OS-MPI/Small-Bore-Imager/Images/1120_Shift Coil Assembly_V1.jpg

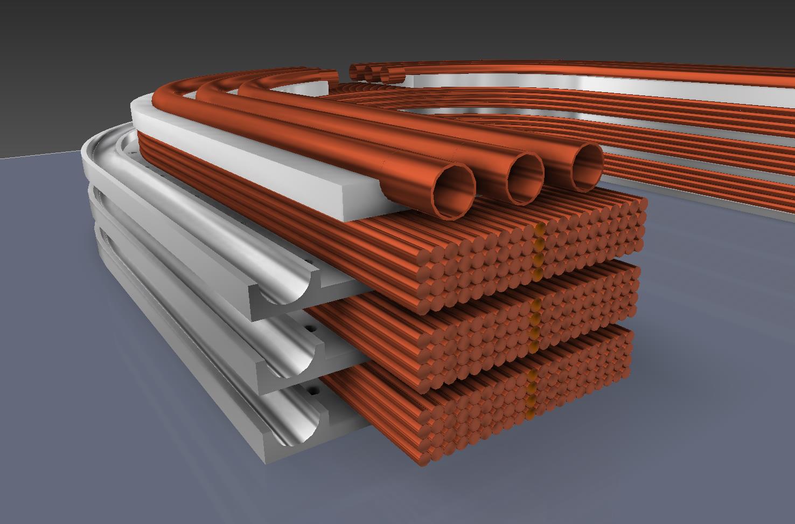
Images/1120_Shift Coil Assembly_V1.jpg
