OS-MPI/Small-Bore-Imager/Images/3100_TxRx Assembly_V1.png

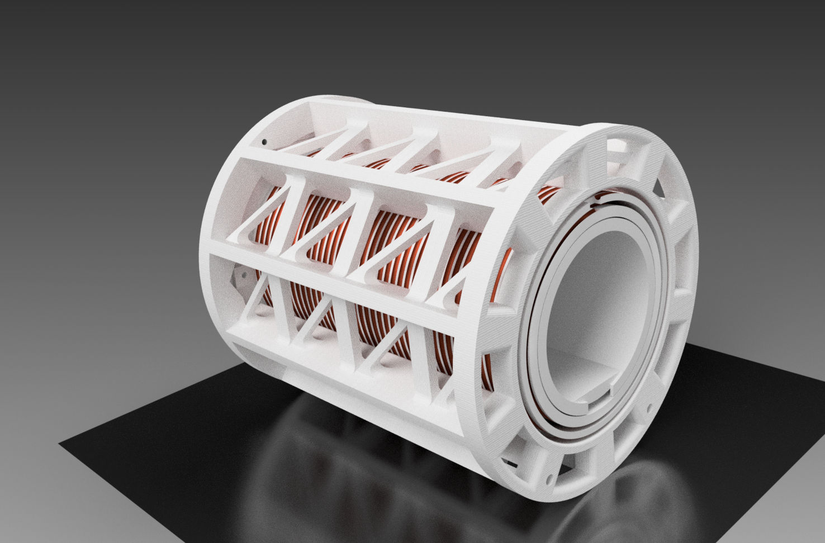
Images/3100_TxRx Assembly_V1.png
