OS-MPI/Small-Bore-Imager/README.md

# Small Bore Imager
# [Link to Wiki](https://github.com/OS-MPI/Small-Bore-Imager/wiki)



This project encompasses the small-bore imager platform with all supporting files and documentation
