OS-MPI/Small-Bore-Imager/General Documentation/Modeling/Magnetics/Symmetry_Sims_Figure.pptx

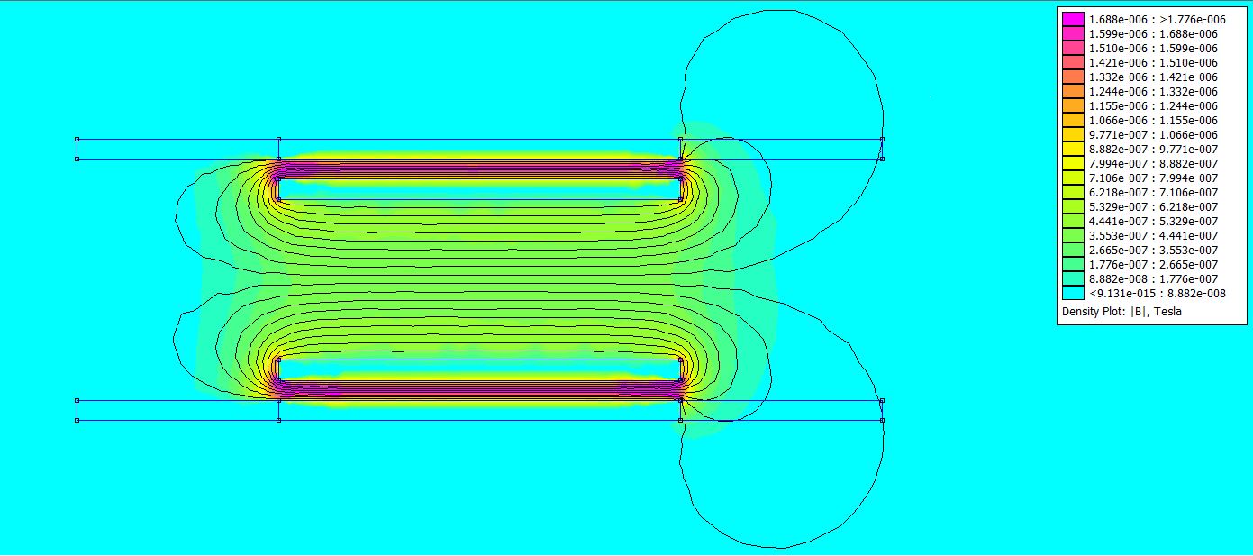
[picture p3: figure]

Copper Tube

Solenoid

Solenoid

Copper Tube
