OS-MPI/Small-Bore-Imager/Filters/Rodent_Tx_filter_Trimmed.pdf

## Small-bore imager drive filter

Eli Mattingly

July 2021

## 1 Introduction

A persistent challenge in the design and construction of the small-bore imaging platform is effectively filtering and optimally powering the drive coil, and then filtering the received signal. This document will summarize the design of these system, in detail. The goal of the filter is to allow for the coil to be powered with a maximally pure waveform as well as being optimally thermally stable.

## 2 Drive Filter

### 2.1 Optimal impedance matching

The drive coil is an inductor with an impedance (ignoring parasitics) of ZL = jωLD + RD, where LD and RD and are the drive coil’s inductance (130µH) and series resistance(400mΩ) respectively, as seen in fig. 2. The amplifier (AE Techron 7548) is a voltage source that for maximum power delivery will drive a 4Ω load. This will be modeled as a source impedance of 4Ω (fig. 1) going forward. If we were to directly power the drive coil at 25kHz with the amplifier, the reactive impedance of the drive coil would dominate:

2 ∗ jωVS

4Ω

Figure 1: The equivalent model for the amplifier. The source resistance is not physical but rather is included to ensure the load is matched to a proper source impedance. In order to ensure the voltage is seen at the load is jωVs and compensate for the artificial resistor, the source voltage is doubled. See appendix A for more detail.

ZD =

q
(2 ∗ π ∗ 25kHz ∗ 130µH)
2 + (4Ω + 0.4Ω)² = 20.9Ω | (1)

LD

RD

Figure 2: The model for the drive coil. Winding capacitances are assumed to be negligible.

Resulting in only a small amount of current being delivered to the coil:

ID =

2VS
20.9Ω → 95mA / Volt | (2)

Where the 20.9Ω is the source impedance in series with the load. This reactance can be easily nulled with a series capacitor, such that at the drive frequency ωLD =

1
ωCD

, so:

CD =

1
ω² ∗ LD

=

1
(2 ∗ pi ∗ 25000Hz)

2 ∗ 130µH

= 312nF | (3)

With that capacitor in place the effective circuit is now simply a 400mΩ resistor, but the amplifiers internal current limits would prevent it from maximum power delivery. This is illustrated by the 4Ω source resistance, which effectively divides the voltage seen at the load. Now the drive coil would receive:

ID =

2VS
4.4Ω = 450mA / Volt | (4)

Which is much better, but there is still substantial room to improve both in terms of matching and filtering. The issue currently is the load is not impedance matched to the source. Ideally, for maximum power delivery, the load would present itself as 4 Ohms to the source.
To accomplish this, we can simply add an impedance matching stage as seen in figure 3. Defining the “matching factor (m)” as the relative ratios of source and load impedance:

m =

RS
RL

=

4Ω
0.4Ω = 10 | (5)

And:
Q =

√
m − 1 = 3 | (6)

For matching to occur:
XL = Q ∗ RL = 1.2Ω | (7)

Which, for resonance at the drive frequency requires the capacitor’s reactance to equal:

1
ωC1

= XL ∗ (1 + Q

−2
) → C1 =

1
ω² ∗ L1 ∗ (10/9) = 4.77µF | (8)

Implementing this results in approximately 800mA per volt. This is the nearly the theoretical maximum with this source impedance, because if we consider conservation of energy, the power

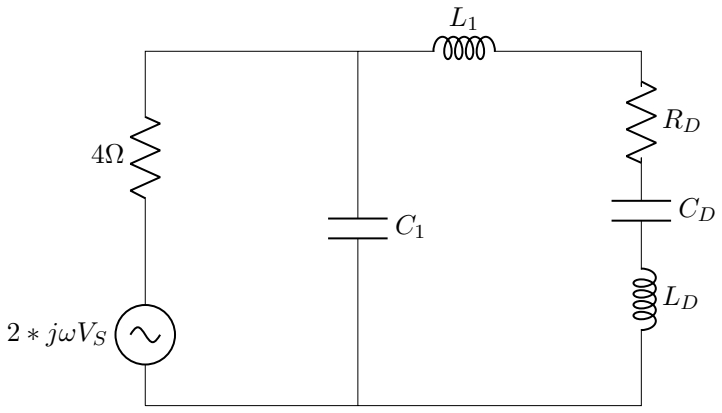
[picture p4: figure]
2 ∗ jωVS

Figure 3: The drive coil circuit with a single impedance matching stage added (L1, C1). In order to form an effective impedance match, L1 = 7.6µH, C1 = 4.7µF, CD = 312nF. This is “Design C-1” in Table 1. L1 can be removed if CD and C1 are picked to be C1 = 4.77µF, CD = 331nF. This version (with no L1) is “Design C-2”.

dissipated by the source PS = V

2/R must equal the power dissipated in the load (if it is perfectly matched and the other elements are ideal). So:

PS = V

2
/R = PD = I

2
D ∗ RD → ID =

s
1
RS ∗ RD
= 800mA / Volt | (9)

In the case where CD is picked properly, we can do the full impedance matching without needing an additional inductor. To do so, we first observe that a parallel capacitor to LD, CD, RD will only add positive imaginary components to the admittance (also called the “susceptance”, “B”) when looking from the source. This means the real part of the admittance (called the “conductance”, G) of the series components, LD, CD, RD must equal 1
RS

. For this to occur, the following must hold:

XSeries = +QRD | (10)

Where the Q is the same as previously defined. The necessary series capacitor is straightforward to calculate:

XSeries = XC + XL | (11)
XC = −(XL − QRD) = 1.2 − 20.4Ω = −19.2Ω = −1 ωCD

(12)

CD =

1
ωXC
= 331nF | (13)

The equivalent impedance of the series drive coil with capacitor is now RD + jQRD. To remove the imaginary component, we first convert the impedance(Z) to an admittance(Y) given Z = 1/Y . Now, looking from the source, the admittance looks like:

Y =

1
RD + jQRD

(14)

Multiplying the numerator and denominator by the complex conjugate gives:

Y =

RD − jQRD
(RD + jQRD)(RD − jQRD)

=

RD − jQRD
(R²
D + (QRD)

2)

=

RD
R²
D(1 + Q²)

−

jQRD
R²
D(1 + Q²)

(15)

Utilizing Eqns. 5,6 gives:

Y =

RD
R²
D(Rs/RD)

−

jQRD
R²
D(Rs/RD)

=

1
Rs

−

jQ
Rs

(16)

Therefore, the susceptance of the shunt capacitor must equal:

BC = +

Q
RS
= ωC | (17)

Which results in a capacitor of:

C = +

Q
ωRS
= 4.77µF | (18)

With that implemented, the equivalent input impedance at the drive frequency is equal to:

Z =

1
Y
= RS | (19)

A third alternative design would be to impedance match to the drive coil’s reactive and resistive load without adding a capacitor and cancel the reactance with a parallel C to the drive and a series L before that as in figure 4, and this results in L2 = 410µH, C2 = 410nF. While the inductor value is very large, the current flowing through is roughly 3x less than the drive coil, so 9x less power/heat (probably 2x resistance, though so overall more like 5x less power than the drive coil). This design is less favorable due to needing to wind another inductor, which can become quite large.

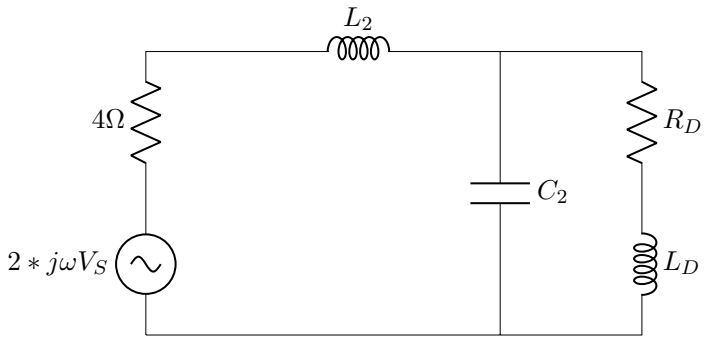
[picture p5: figure]
2 ∗ jωVS

Figure 4: The drive coil circuit with an alternative impedance matching stage added (L2, C2). Note there is no series capacitor to the drive coil.For matching L2 = 409µH, C1 = 410nF. This has the advantage of very low required capacitance. This is “Design D” in Table 1

Regardless of the design specifics, the Q of the filter is dependent on the matching ratio (Eqn. 6). Increasing the filter Q has multiple effects: First, the losses in a filter with higher impedance will be much lower, and second, the way the system drifts with temperature will change–this is discussed later, though. To the first note, we observe for conservation of power (and ignoring filter losses):
I

2
SRS = I

2
DRD | (20)

(

IS
ID

)

2 =

RD
RS

(21)

So, as the source impedance increases, the current decreases. For an impedance matched filter, the same logic holds, where high impedance filters have smaller currents flowing. The characteristic impedance of a filter is defined as:

Z0 =

s
L
C

→ Z

2
0C = L | (22)

and in an ideal resonant circuit energy flows between the inductor and capacitor such that

1/2 ∗ LI² = 1/2 ∗ CV ²
(23)

Plugging in the characteristic impedance and cancelling like terms:

Z

2/0 I

2 = V

2 → Z0 = V /I | (24)

If we consider the losses are proportional to the current squared, then the impedance of the filter is inversely proportional to the losses, squared. This is a simplification of course, as capacitors dissipate heat and resistive components are a function of inductance, but it can still be useful to guide the design.
This suggests a filter matched to a higher impedance would be less lossy at the cost of potentially higher voltages and bigger capacitors and inductors. At higher impedances, the amplifier may lose efficiency, though. Taking AE Techron 7224 as an example, the max power it can transfer at 8 Ohms is 900W, but at 16 Ohms it can still power over 700W. The AE Techron 7548, at 4 Ohms can supply 3300W, but at 16 Ohms it can only supply 1100W. Given the resistance of the drive coil is 400mΩ and we want 25A, that means we only need the amplifier to supply 250W (plus any filter losses).

### 2.2 Filtering

The next challenge is the low F3/F1 attenuation, which can be solved by adding a LC band pass filter with a minimally small pass-band around the drive frequency. So that means making a T network where the series sections are series resonant L-C sections and the shunt sections are parallel L-C sections such that at resonance the series sections have no reactance and minimal resistance, and the shunt sections appear to have practically infinite impedance. With this arrangement, the filter does not alter the impedance matching.

## 3 Transformer Design

Transformers can be used on both the Tx and Rx systems for galvanic isolation, balancing loads, common-mode noise rejection among other reasons. While they present an attractive option for those reasons, the design must be carefully considered to minimize risk of harmonic distortion, and added noise. In particular, the major risks (in this context) are the core becoming saturated and adding harmonic distortion, heating, or (for Rx) adding resistive noise.
For any transformer, the operation is fundamentally the same: current in the Np primary windings induce an alternating flux, ΦC in the core that energizes the secondary Ns windings with
Ns
Np

volts and an inverse ratio of current (ideally). The ratio of turns therefore is the governing factor for the voltages/currents, but the absolute number of turns in each, in conjunction with geometric/composition parameters, determines the “magnetizing inductance”, LM, the leakage inductance, LL, as well as the flux density in the core, Bc.

First, looking at the inductances, there are two major values to consider. The “magnetizing” inductance, and the second is the “leakage” inductance. Simply, the magnetizing inductance is the integrated flux in the core that couples to the secondary per ampere, and the leakage is the integrated remaining flux per ampere. There is a magnetizing inductance for both the primary and secondary.
Next, we must consider the flux density within the core to determine if it will saturate. This was derived in (among other sources) Magnetic Circuits and Transformers, 1943 (Pg. 167-8), and is repeated here for completion. Consider the situation where a transformer (negligible wire losses) has a voltage v applied to the primary side, which must be equivalent to N

dϕ
dt , where N is the
primary-side turn count. ϕ can be written as:
ϕ = ϕmaxsin(ωt) | (25)

differentiating gives:

v = N

dϕ
dt = ωNϕmaxcos(ωt) | (26)

Substituting 2πf for ω and solving for ϕmax, and recognizing the cosine goes to a maximum of 1:

ϕmax =

v
2πfN | (27)

It is worth noting that in many texts it is written as:

vef f =

2πfNϕmax √
2
≈ 4.44fNϕmax | (28)

But this assumes the RMS value. In order to determine saturation or not, it is useful to put it in terms of the flux density, which is a simple transformation as BA = ϕ, so:

Bmax =

v
2πfNA | (29)

This expression is in terms of the voltage at the primary side, but does not include secondary-side effects. This can be explain intuitively, if we assume a near-ideal 1:1 transformer. If a load is applied to the secondary side and draws X amps, the primary side current will increase an equal amount, so the flux within the core remains essentially the same.

### 3.0.1 Equivalent circuit

As mentioned, the transformer has two inductances each, for the primary and secondary side: the “LM”, the magnetizing inductance, and “Ll” the leakage inductance. With these four parameters, an equivalent circuit can be formed as in figure 5. It is common to refer all of the impedances to either the primary or secondary side. For this discussion, the secondary side will be more simple to refer the impedances to.
In the case that the magnetizing inductive impedance is substantially higher than the effective resistive load (at the drive frequency), this term can be ignored. This results in the equivalent circuit simply being a series inductor with a value equal to the sum of the leakages referred to the secondary side. This can be easily tuned out by adding a series capacitor such that it resonates at the drive frequency.

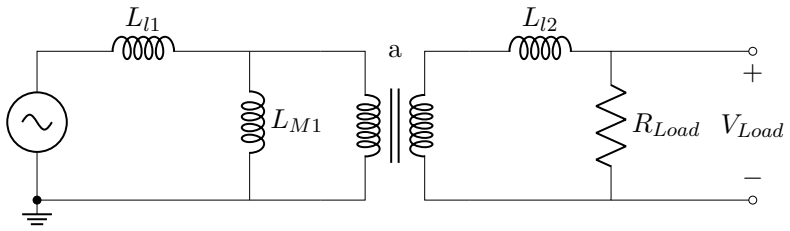
[picture p6: figure]
RLoad; VLoad

Figure 5: Circuit model for a generalized transformer with both secondary and primary-side leakages as well as the magnetizing inductance on the primary side. The transformer in the center is an ideal transformer with a turns ratio equivalent to the square root of the magnetizing inductance ratio (qLM1

LM2

= a). This model assumes negligible capacitive effects, and core losses.

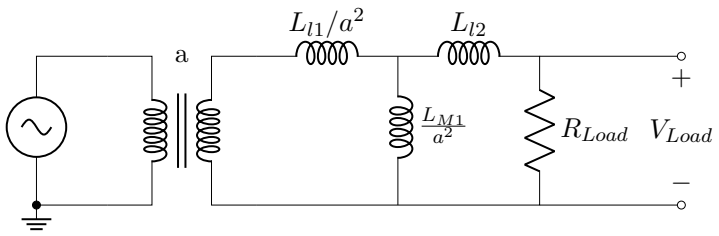
[picture p7: figure]
RLoad; VLoad

Figure 6: Circuit model for a generalized transformer with both secondary and primary-side leakages as well as the magnetizing inductance on the primary side. The transformer in the center is an ideal transformer with a turns ratio equivalent to the square root of the magnetizing inductance ratio (qLM1

LM2

= a).

## 4 Implementation

The discussion has been mostly theory-based so far, which in a general sense is useful to guide a design, but reality tends to fight back on the implementation front. A number of new effects must be considered. Firstly, the amplifier is actually a fairly low impedance source (< 10mΩ) not the four or so Ohms that was assumed earlier. This may result in some unexpected behavior in non-drive frequencies, because now the amplifier can supply substantially more current to low-impedance loads (whereas before the simulated source resistance attenuated it).
The transfer function (voltage input to drive current) ends up having a peak on either side of the drive frequency, which may come as a surprise. The relative location of these peaks depend on which impedance the load is matched to, and a number of different impedances are plotted in figure 7a. When plotting the total efficiency (power out/power in), the drive frequency is indeed the absolute maximum.

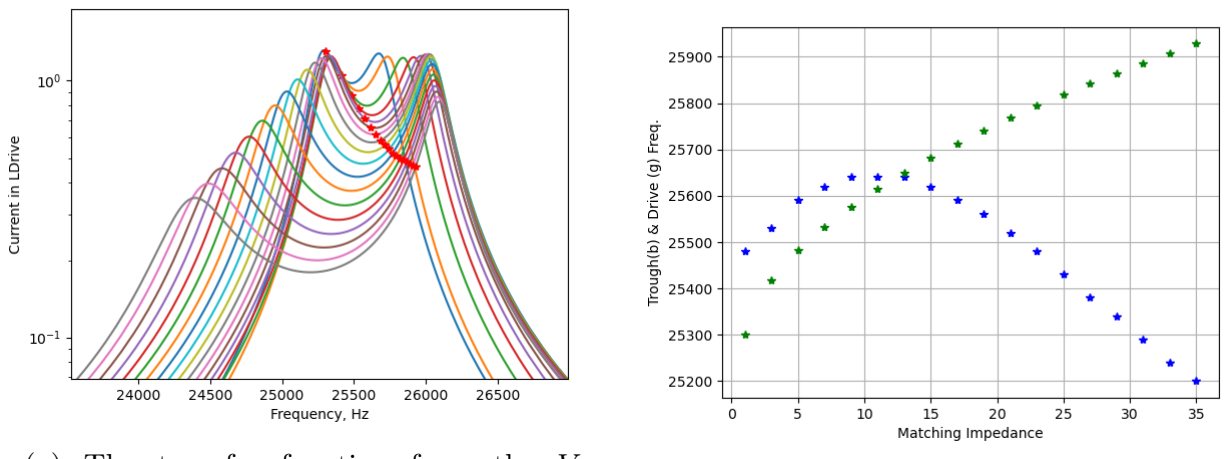
[picture p8: figure]

(a) The transfer function from the Vin to IDrive for many different matching impedances. Red stars are the drive frequencies
(b) The “trough” location and the oper-ating drive frequency at different matched impedances

Figure 7: Impedance matching to different levels (changing matching ratio) causes the relative position of the drive frequency and the “trough”, which is the local minima, to be varied.

## Appendices

## A Modeling voltage sources

Throughout this document I model the amplifier as a voltage source in series with a resistor that is equivalent to the amplifier’s maximum output voltage divided by the maximum current:

RSrc =

VMax

IMax

(30)

This is an approximation that can be used to help design the filter, but this is not a physical effect. As shown in figure 10, it is evident that the match is far from perfect, but it does indeed match exactly at the maximum power point, and roughly matches the off-peak characteristics in that it monotonically attenuates them. If this series resistor, the maximum power would be at zero ohms load as P = V

2/R.

## B Phasor view of impedance matching

A second way to understand the impedance matching is by looking at the phasors of the impedance and admittance depicted in figure 11. From this prespective the steps are more clear: first, looking at the admittance, the goal is to move the green admittance such that the real part is aligned with the target. This is done by adding series capacitance. Next, adding parallel capacitance adds positive, imaginary admittance, so that parallel capacitor is picked to cancel out all of the reactance.

Design | ID per VS | SPICE Source Impedance | F3/F1 | Filer losses
A B C-1 C-2 D E F F-2 | 95mA/V 450mA/V 800mA/V 800mA/V 800mA/V 700mA/V 800mA/V 800mA/V | 20.9Ω, 100◦ ◦ 4.4Ω, 0 8.2Ω, −2 ◦ ◦ 7.9Ω, 2 7.96Ω, 2 ◦ 6.58Ω, 22◦ 8.0Ω, −3 ◦ ◦ 7.94Ω, −3 | -9.4dB -21dB -46dB -46dB -58dB -80dB -81dB -79dB | --30 W -25.4 W 46 W 43.5 W 28 W

Table 1: Tabulated parameters for each of the different filter versions. The SPICE source impedance is in series with the 4 Ω source impedance. For the losses, capacitors are assumed to be ideal, as are wires, and resistance is taken to be approximately 200mΩper√
100µH, so for example, a 25µH would have 100mΩ resistance

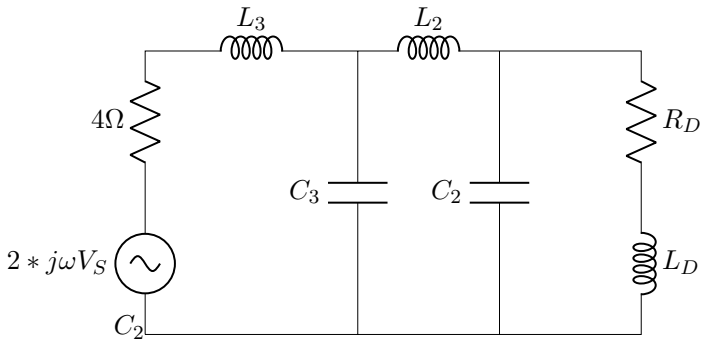
[picture p9: figure]
2 ∗ jωVS

Figure 8: The drive coil circuit with a single impedance matching stage added (L2, C2) as well as a filter (L3, C3) to attenuate harmonic distortions that originate from the amplifier. This is “Design E” in Table 1

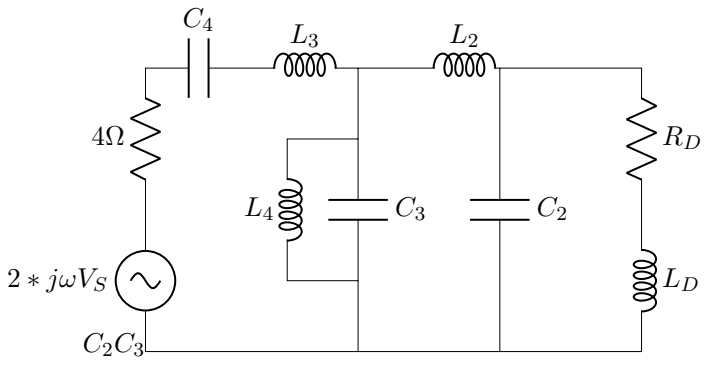
[picture p10: figure]
2 ∗ jωVS

Figure 9: The drive coil circuit with a single impedance matching stage added (L2, C2.) as well as a filter (L3, C3.) which has been tuned such that it is resonant at the drive frequency (L4, C4.). This is “Design F” in Table 1

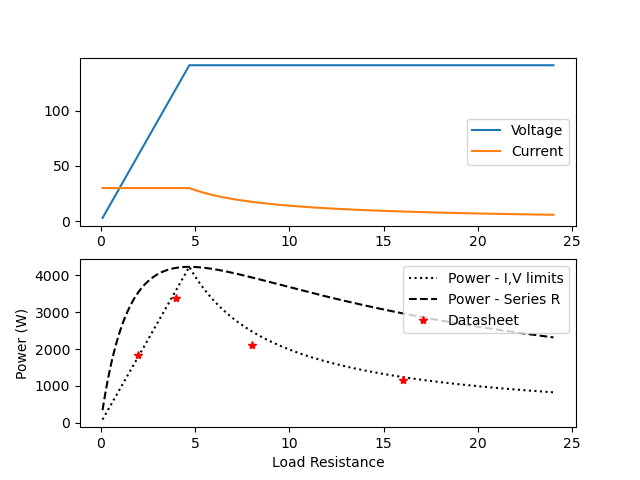
[picture p11: figure]

Figure 10: Top: The actual currents and voltages that one would expect from an amplifier given the maximum current and voltages of the AE Techron 7548 (RMS, steady state). Bottom: The dotted line is the power as a function of load impedance that corresponds to the top I and V. The dashed line is the approximation that utilizes the source having twice the voltage with a series resistance as calculated in Eqn.30. The four red stars are the datapoints found in the AE Techron 7548 datasheet.

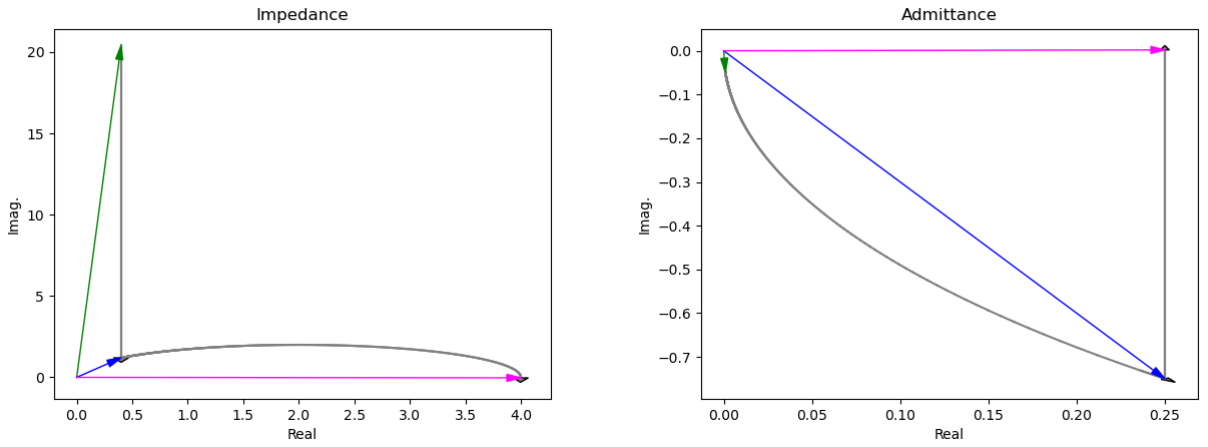
[picture p12: figure]

(a) The impedance phasors | (b) The admittance phasors

Figure 11: Impedance matching from a graphical point of view. The green represents the original impedance , the blue is the drive coil with the 331nF series capacitor, and the magenta is the final, impedance matched system (4.77µF capacitor added in parallel as in design “C-2”.
