OS-MPI/Small-Bore-Imager/Filters/Tx_Filter_SPICE.png

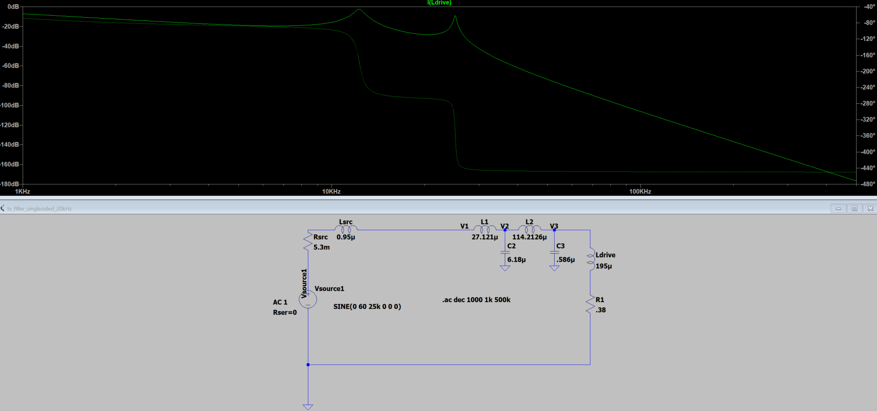
Filters/Tx_Filter_SPICE.png
