OS-MPI/Small-Bore-Imager/Filters/Tx_Filter_SPICE_Detail.png

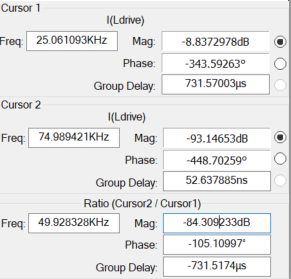
Filters/Tx_Filter_SPICE_Detail.png
