OS-MPI/Small-Bore-Imager/General Documentation/Modeling/Magnetics/FieldSim_40Amps.PNG

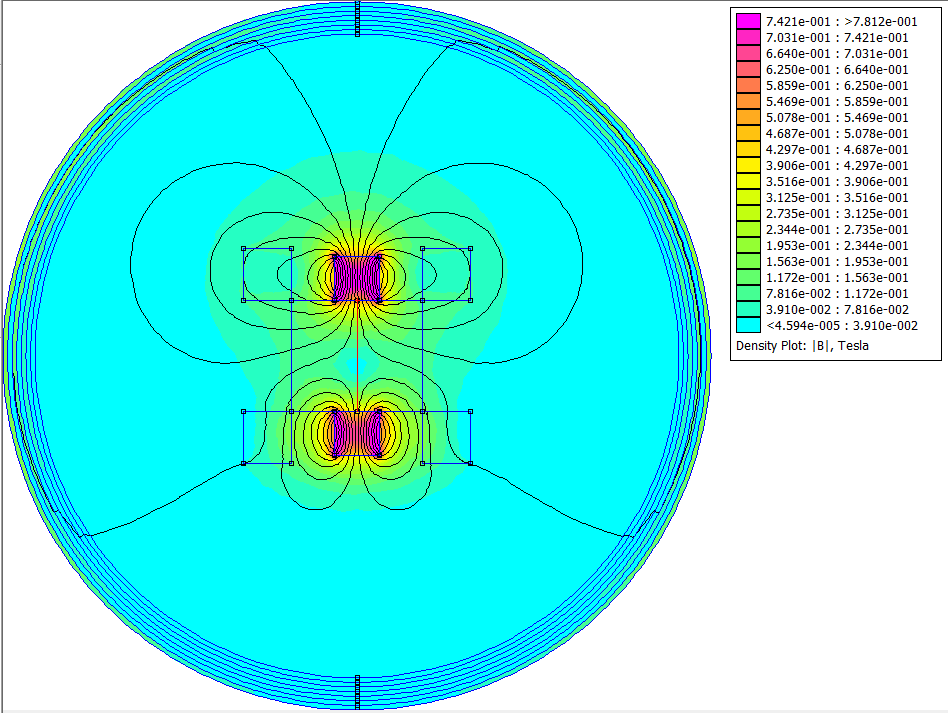
General Documentation/Modeling/Magnetics/FieldSim_40Amps.PNG
