OS-MPI/Small-Bore-Imager/General Documentation/Modeling/Magnetics/FieldSim_40Amps_Plot.PNG

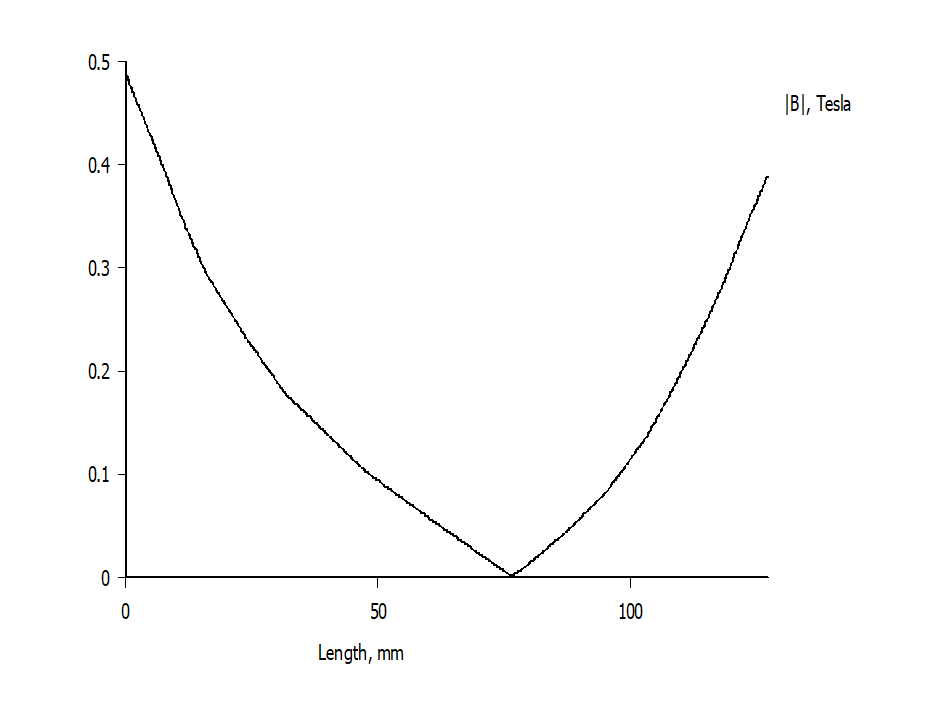
General Documentation/Modeling/Magnetics/FieldSim_40Amps_Plot.PNG
