OS-MPI/Small-Bore-Imager/General Documentation/Modeling/Magnetics/Magnet_Cross_Section_ExplicitLayers_Minus16AWG.PNG

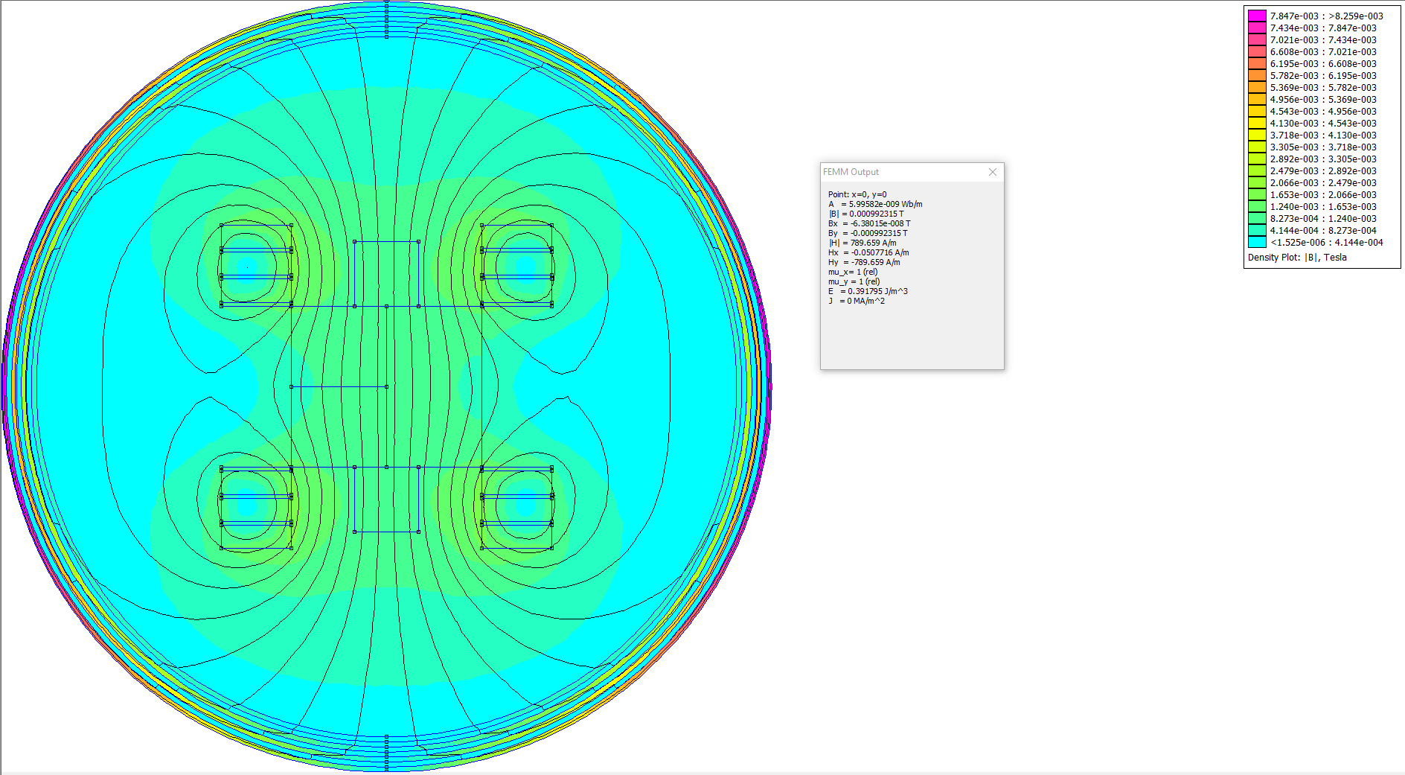
General Documentation/Modeling/Magnetics/Magnet_Cross_Section_ExplicitLayers_Minus16AWG.PNG
