OS-MPI/Small-Bore-Imager/General Documentation/Modeling/Magnetics/Symmetry_Sims_Figure.png

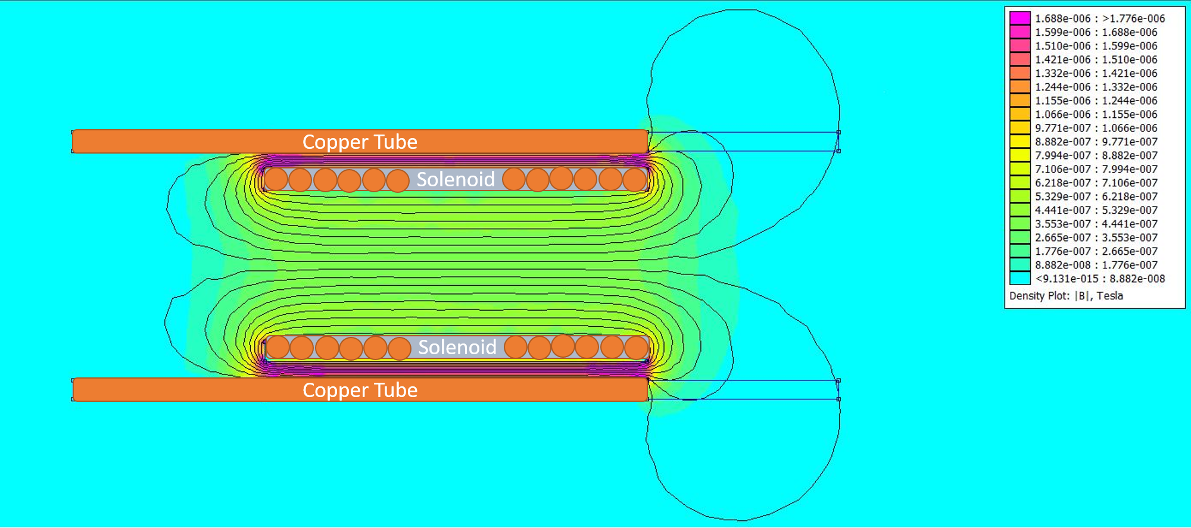
General Documentation/Modeling/Magnetics/Symmetry_Sims_Figure.png
