OS-MPI/Small-Bore-Imager/General Documentation/Modeling/Thermal/Cross_Section_4x20_1.5mmSiC.jpg

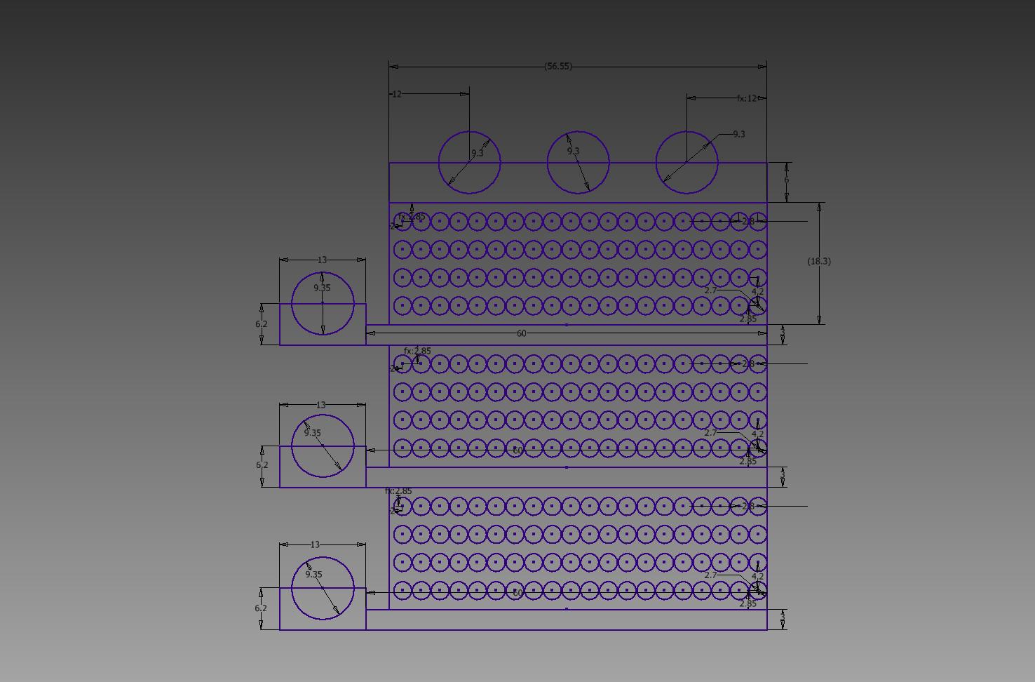
General Documentation/Modeling/Thermal/Cross_Section_4x20_1.5mmSiC.jpg
