OS-MPI/Small-Bore-Imager/General Documentation/Modeling/Thermal/Cross_Section_4x20_1.5mmSiC_Extra14AWGLayer.jpg

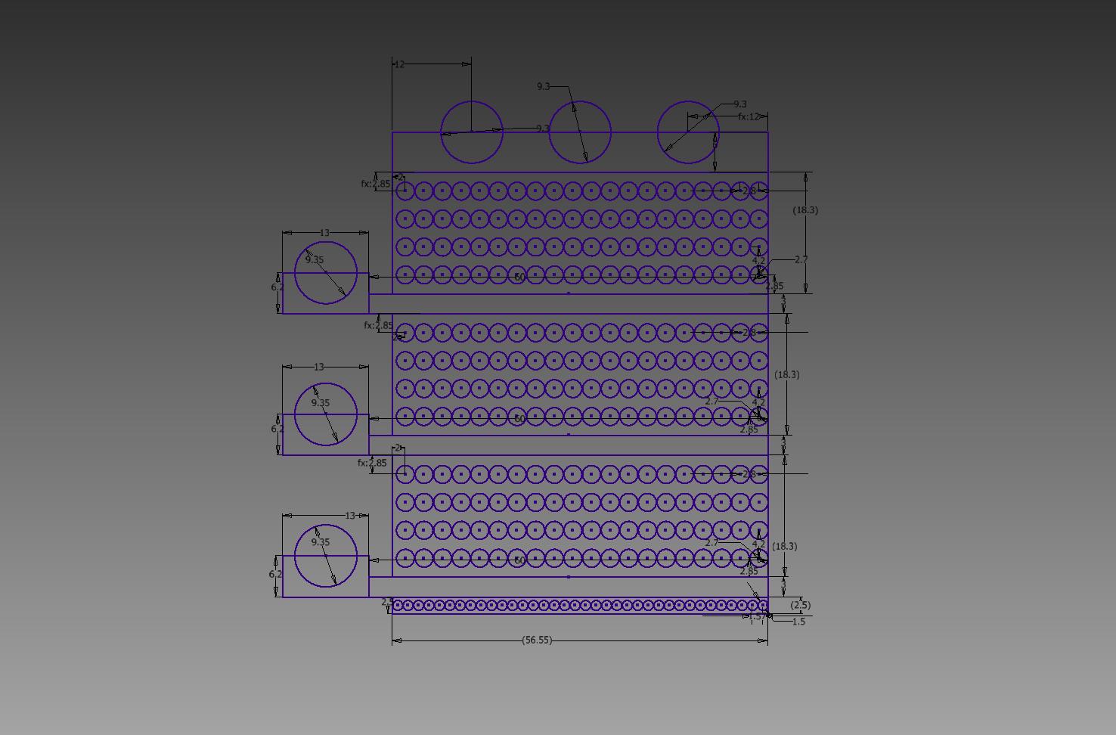
General Documentation/Modeling/Thermal/Cross_Section_4x20_1.5mmSiC_Extra14AWGLayer.jpg
