OS-MPI/Small-Bore-Imager/General Documentation/Modeling/Thermal/ThermalModel_34Amps_ExtraLayer.PNG

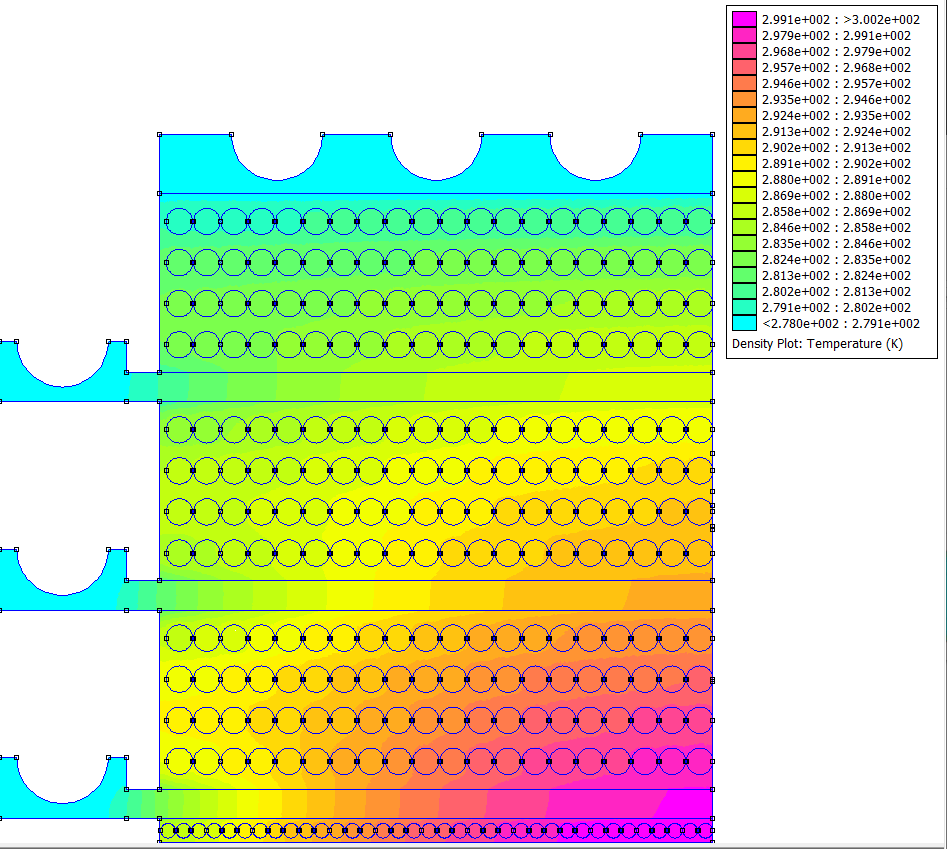
General Documentation/Modeling/Thermal/ThermalModel_34Amps_ExtraLayer.PNG
