OS-MPI/Small-Bore-Imager/General Documentation/Modeling/Thermal/ThermalModel_40Amps.PNG

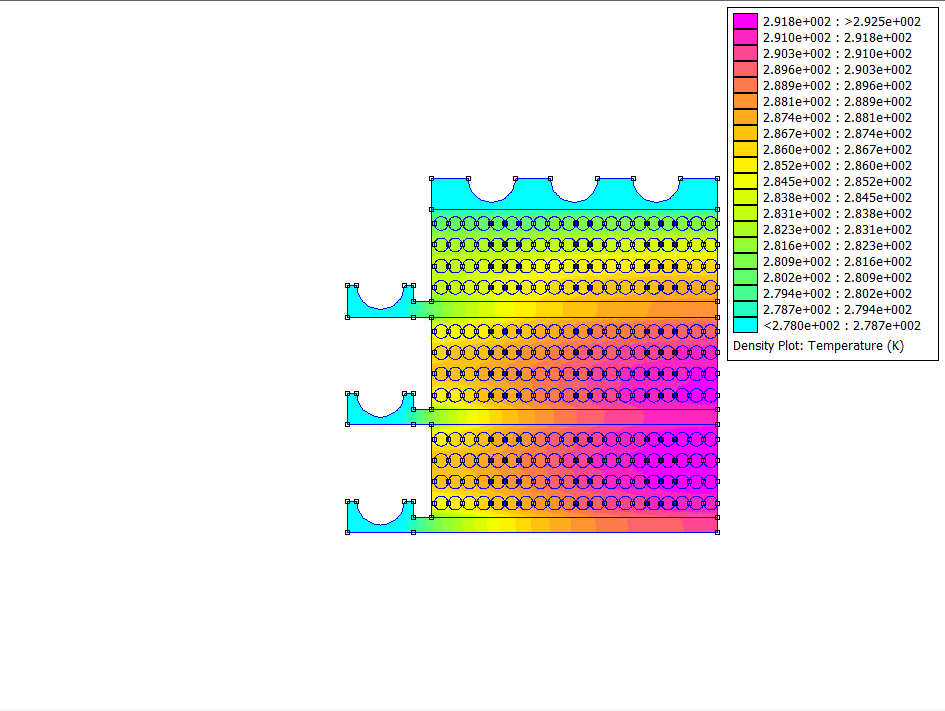
General Documentation/Modeling/Thermal/ThermalModel_40Amps.PNG
