OS-MPI/Small-Bore-Imager/Images/2-0000_Small Bore Imager_V1_RotatingGantry.png

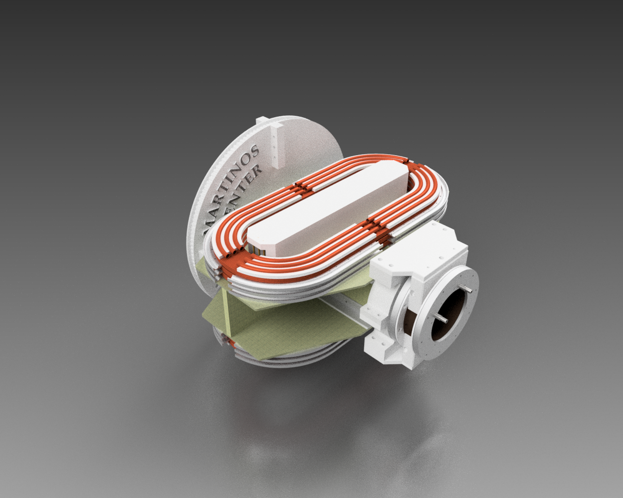
Images/2-0000_Small Bore Imager_V1_RotatingGantry.png
