OS-MPI/Small-Bore-Imager/Images/1122_Middle Heat Sink_V1.png

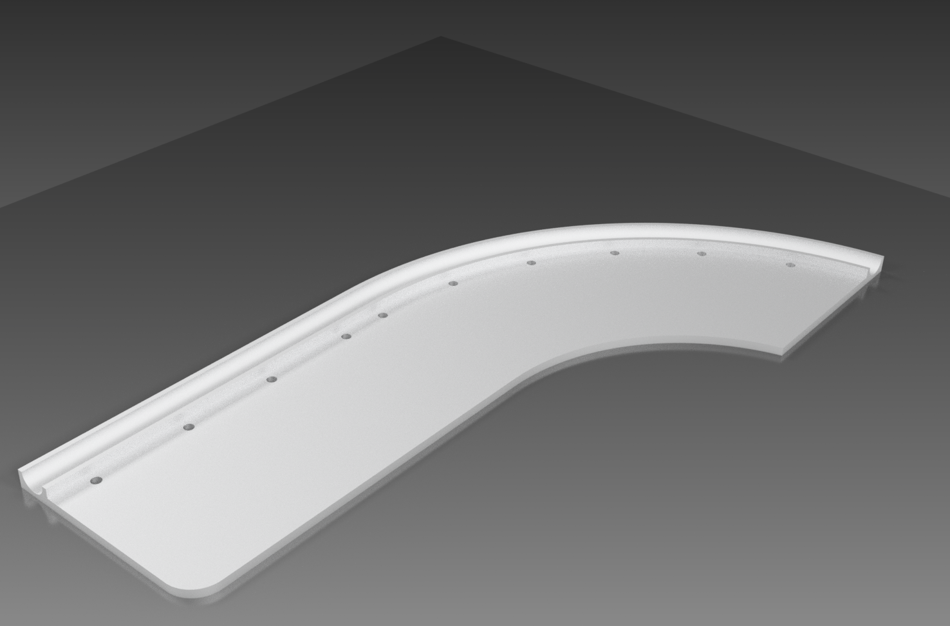
Images/1122_Middle Heat Sink_V1.png
