OS-MPI/Small-Bore-Imager/Images/1123_Top Heat Sink_V1.png

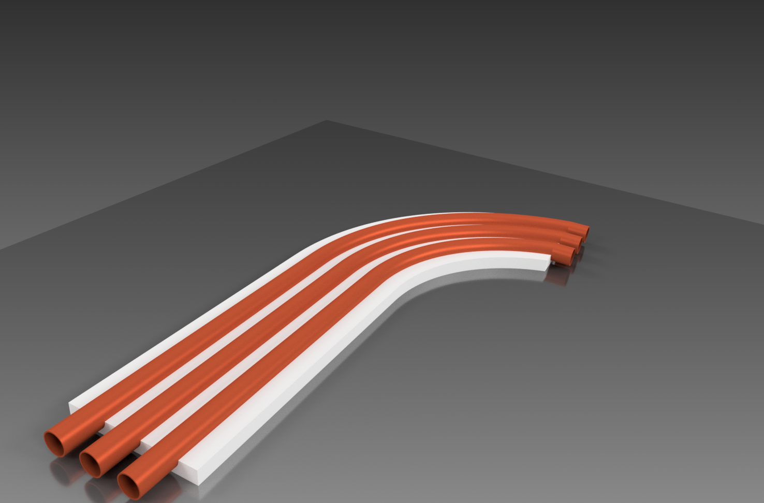
Images/1123_Top Heat Sink_V1.png
