OS-MPI/Small-Bore-Imager/Images/1123_Top Heat Sink_V1_Top.png

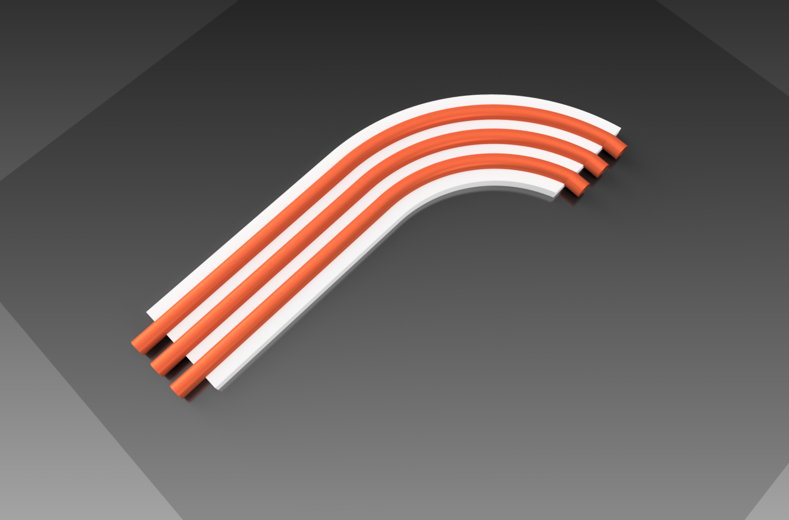
Images/1123_Top Heat Sink_V1_Top.png
