OS-MPI/Small-Bore-Imager/Images/3000_Inside Bore and Rails_V1.png

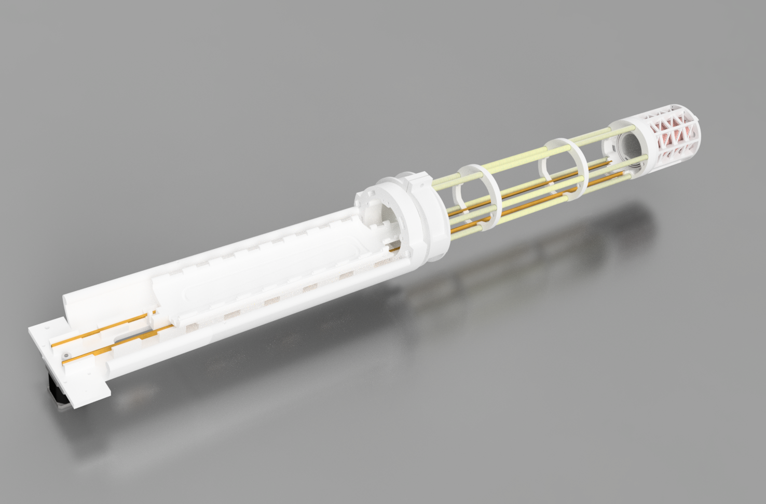
Images/3000_Inside Bore and Rails_V1.png
