OS-MPI/Small-Bore-Imager/Images/DiamondSelectionCoils.png

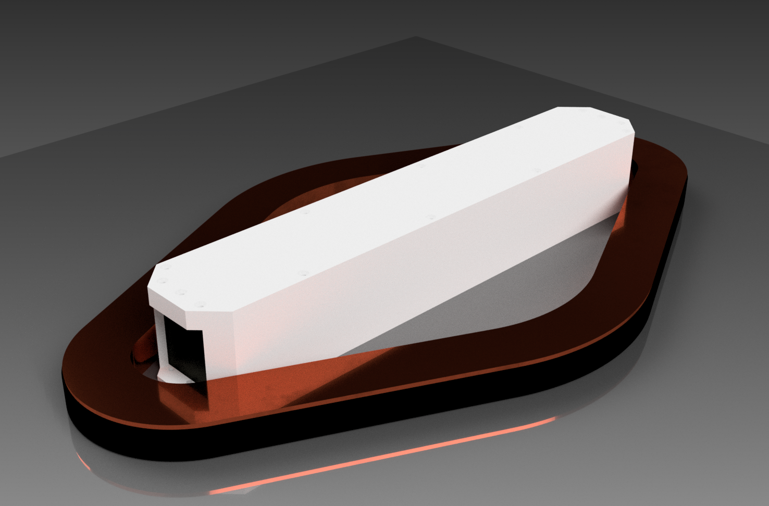
Images/DiamondSelectionCoils.png
