OS-MPI/Small-Bore-Imager/Images/DiamondSelectionCoils_Top.png

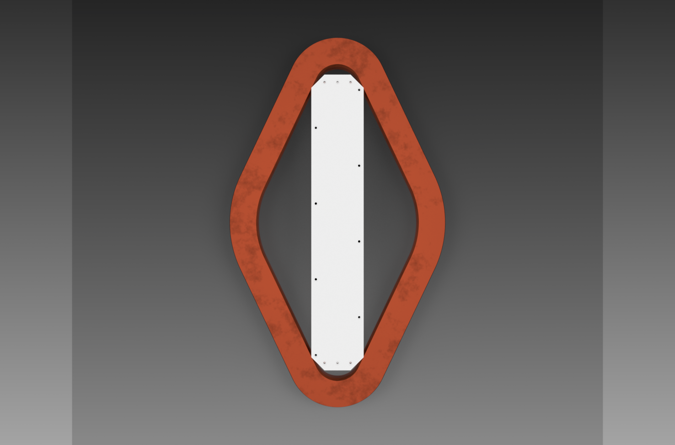
Images/DiamondSelectionCoils_Top.png
