OS-MPI/Small-Bore-Imager/Images/Rotary Union Illustration.png

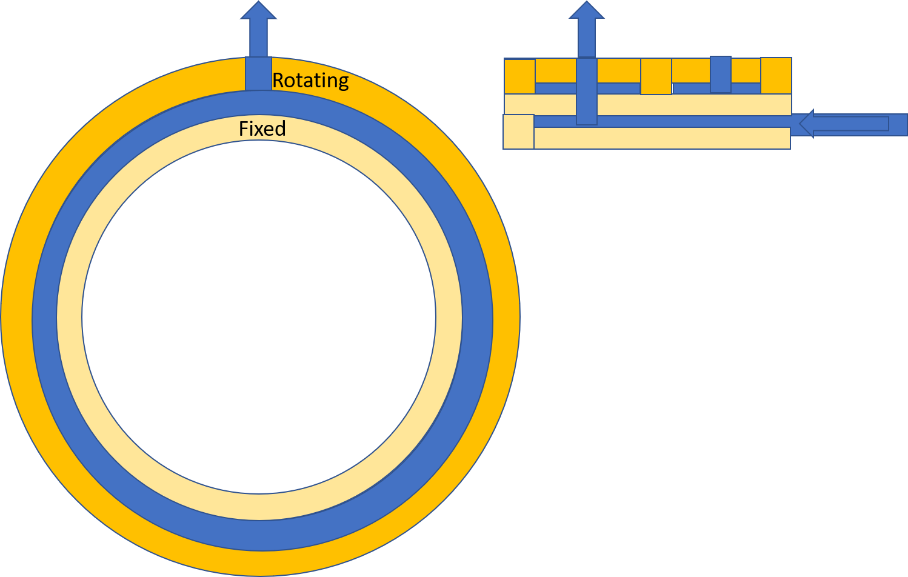
Images/Rotary Union Illustration.png
