OS-MPI/Small-Bore-Imager/M-Phantom.png

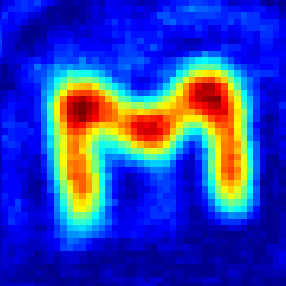
M-Phantom.png
