OS-MPI/Small-Bore-Imager/General Documentation/OSMPI Part Management-MPI.xlsx

Small Bore MPI Project Management Spreadsheet |  |  |  |  |  |  |  |  |  |  |  |  |  |  |  |  |  |  |  |  | Drop-down menu source:
 |  |  |  |  |  |  |  |  |  |  |  |  |  |  |  |  |  |  |  |  | Yes | CNC Milling
Part Number (2-####) |  |  |  |  | Part Name | Quantitiy | Material | Designed (.5 = Drawn, 1 = Drawn& Saved properly) | Fabricated/Purchased | Assembled | Notes | Made in lab | Method of Mfg | Quoted (& Quote No.) | Paid | P.O. Number | Part Mass | Total Mass (kg) | Cost (USD) | Total Cost (USD) | No | 3D Print
 |  |  |  |  |  | 248 |  | 100.00% | 93.33% | 93.33% |  |  |  |  |  |  |  | 193.67 |  | $72091.42
1 | 0 | 0 | 0 |  | Rotating Gantry | 1 | N/A |  |  |  |  | Yes |  | N/A | N/A | N/A |  |  | N/A | N/A
1 | 1 | 0 | 0 |  | Magnet Assembly | 2 | N/A | 1 | 1 | 1 |  | Yes |  | N/A | N/A | N/A |  |  | N/A | N/A
1 | 1 | 1 | 0 |  | Permanent Magnet | 2 | NdFeB | 1 | 1 | 1 |  | Yes |  |  | N/A | N/A |  |  | N/A | N/A
1 | 1 | 1 | 1 |  | Magnet Brick SubAssembly | 2 | NdFeB | 1 | 0 | 0 |  | Yes |  | N/A | N/A | N/A |  |  |  | N/A
1 | 1 | 1 | 1 | A | Individual NdFeB Block | 8 | NdFeB | 1 | 1 | 1 |  | No |  |  |  |  | 2.09 | 16.72 | $183.99 | $1471.92
1 | 1 | 1 | 2 |  | Magnet Brick Housing | 2 | NdFeB | 1 | 1 | 1 |  | Yes | CNC Milling | N/A | N/A | N/A | 1.48 | 2.96 | N/A | N/A
1 | 1 | 2 | 0 |  | Shift Coil Assembly | 2 |  |  |  |  |  | Yes |  | N/A | N/A | N/A |  |  | N/A | N/A
1 | 1 | 2 | 1 |  | Shift Coils SubAssembly | 4 | Copper | 1 | 1 | 1 |  | Yes |  | N/A | N/A | N/A |  |  | N/A | N/A
1 | 1 | 2 | 1 | A | Shift Coil Layer | 32 | Copper | 1 | 1 | 1 |  | Yes |  | N/A |  |  | 1.27 | 40.64 | N/A | N/A
1 | 1 | 2 | 2 |  | Middle Heat Sink | 8 | Aluminum | 1 | 0 | 0 |  | No | CNC Milling |  |  |  | 0.17 | 1.36 | 41.55 | $332.40
1 | 1 | 2 | 2 | A | Middle Heat Sink Mirror | 8 | Aluminum | 1 | 0 | 0 |  | No | CNC Milling |  |  |  | 0.17 | 1.36 | $41.55 | $332.40
1 | 1 | 2 | 3 |  | Top Heat Sink | 4 | Aluminum | 1 | 0 | 0 |  | No | CNC Milling |  |  |  | 0.21 | 0.84 | $222.06 | $888.24
1 | 1 | 2 | 3 | A | Top Heat Sink Manifold | 2 | Brass | 1 | 0 | 0 |  | Yes | CNC Milling | N/A | N/A | N/A |  |  | N/A | N/A
1 | 1 | 2 | 3 | B | Top Heat Sink Mirror | 4 | Aluminum | 1 | 0 | 0 |  | No | CNC Milling |  |  |  | 0.21 | 0.84 | $222.06 | $888.24
1 | 1 | 3 | 0 |  | Water Rotary Union Assembly | 1 |  | 1 | 1 | 1
1 | 1 | 3 | 1 |  | Inner RU Body | 1 | Bearing Bronze | 1 | 1 | 1 |  | No | CNC Milling |  |  |  | 2 | 2 | $875.00 | $875.00
1 | 1 | 3 | 2 |  | Outer RU Body | 1 | Bearing Bronze | 1 | 1 | 1 |  | No | CNC Milling |  |  |  | 1.05 | 1.05 | $850.00 | $850.00
1 | 1 | 3 | 3 |  | RU End Cap | 2 | Aluminum | 1 | 1 | 1 |  | No | CNC Milling |  |  |  | 0.17 | 0.34 | $360.37 | $720.74
1 | 1 | 3 | 4 |  | O Ring Cap | 2 | Aluminum | 1 | 1 | 1 |  | No | CNC Milling |  |  |  | 0.09 | 0.18 | $304.68 | $609.36
1 | 1 | 3 | 5 |  | Sq O Ring | 2 | Nitrile | 1 | 1 | 1 |  | No |  |  |  |  |  |  |  | $0.00
1 | 1 | 3 | 6 |  | RU Top Plate | 2 | PC | 1 | 1 | 1 |  | No | CNC Milling |  |  |  | 0.05 | 0.1 | $122.00 | $244.00
1 | 1 | 3 | 7 |  | RU Mechanical Connector | 2 | PC | 1 | 1 | 1 |  | No | 3D Print |  |  |  | 0.04 | 0.08 | $65.59 | $131.18
1 | 1 | 3 | 8 |  | Inner Gasket | 2 | Nitrile | 1 | 1 | 1 |  | No |  |  |  |  |  |  |  | $0.00
1 | 1 | 3 | 9 |  | Outer Gasket | 2 | Nitrile | 1 | 1 | 1 |  | No |  |  |  |  |  |  |  | $0.00
1 | 1 | 3 | 10 |  | Pipe Inserts | 2 | Brass | 1 | 1 | 1 |  | No |  |  |  |  |  |  | $259.31 | $518.62
1 | 1 | 4 | 0 |  | Electrical Slip Ring Assembly | 1 |  | 1 | 1 | 1 |  | No |  |  |  |  | 1 | 1 | $729.00 | $729.00
1 | 2 | 0 | 0 |  | Gantry Structure |  |  | 1 | 1 | 1 |  | Yes |  | N/A | N/A | N/A |  |  | N/A | N/A
1 | 2 | 1 | 0 |  | Gantry Structure Assembly |  |  | 1 | 1 | 1 |  | Yes |  | N/A | N/A | N/A |  |  | N/A | N/A
1 | 2 | 1 | 1 |  | Racetrack Board | 2 | FR4 | 1 | 1 | 1 |  | No | CNC Milling |  |  |  | 1.5 | 3 | $76.40 | $152.80
1 | 2 | 1 | 2 |  | Flat Connector | 2 | FR4 | 1 | 1 | 1 |  | No |  |  |  |  | 0.38 | 0.76 | $38.20 | $76.40
1 | 2 | 1 | 3 |  | Angle Stock Bracket | 4 | Aluminum | 1 | 1 | 1 |  | No |  |  |  |  | 0.14 | 0.56 | $2.00 | $8.00
1 | 2 | 1 | 4 |  | Gantry Support Rib | 2 | FR4 | 1 | 1 | 1 |  | No |  |  |  |  | 0.568 | 1.136 | $29.15 | $58.30
1 | 2 | 1 | 5 |  | Bearing | 2 |  | 1 | 1 | 1 |  | No |  |  |  |  | 0.9 | 1.8 | $270.00 | $540.00
1 | 2 | 1 | 6 |  | Bearing Clamp No Pulley | 2 | PC | 1 | 1 | 1 |  | No |  |  |  |  |  |  | $184.00 | $368.00
1 | 2 | 1 | 7 | A-D | Bearing Clamp Gear | 4 | PC | 1 | 1 | 1 |  | No |  |  |  |  |  |  | $454.00 | $1816.00
1 | 2 | 1 | 9 |  | Timing Belt | 1 |  | 1 | 1 | 1
2 | 0 | 0 | 0 |  | Stationary Structure |  |  | 1 | 1 | 1
2 | 1 | 0 | 0 |  | Imager Frame | 1 | Aluminum | 1 | 1 | 1
2 | 1 | 1 | 0 |  | Aluminum Framing | 1 | Aluminum | 1 | 1 | 1 | Estimated Length/costs-- depends on efficiency of cutting from long pieces | No |  |  |  |  | 15 | 15 | $500.00 | $500.00
2 | 1 | 2 | 0 |  | Other Supports |  |  | 1 | 1 | 1
2 | 1 | 2 | 1 |  | Copper Tube Clamp Bottom | 2 | PC | 1 | 1 | 1 |  | No |  |  |  |  |  |  | $120.11 | $240.22
2 | 1 | 2 | 2 |  | Copper Tube Clamp Top | 2 | PC | 1 | 1 | 1 |  | No |  |  |  |  |  |  | $80.44 | $160.88
2 | 1 | 2 | 6 |  | Al Frame End Cap | 10 | PC | 1 | 1 | 1 |  | No |  |  |  |  |  |  |  | $0.00
2 | 1 | 2 | 4 |  | Plywood Frame Top | 1 | Wood | 1 | 1 | 1 |  | No |  |  |  |  | 1.6 | 1.6 |  | $0.00
2 | 1 | 2 | 3 |  | Alum Angle Bracket | 30 | Aluminum | 1 | 1 | 1 | Also an estimation, I recommend buying this and many extra of other kinds of brackets | No |  |  |  |  | 0.01 | 0.3 | $6.58 | $197.40
2 | 1 | 2 | 5 |  | Wood Bench Top | 1 | Wood | 1 | 1 | 1 |  | No |  |  |  |  | 53.58 | 53.58 |  | $0.00
2 | 3 | 0 | 0 |  | Driving Mechanics |  |  | 1 | 1 | 1
2 | 3 | 1 | 0 |  | Drive Train |  |  | 1 | 1 | 1
2 | 3 | 1 | 1 |  | Motor | 1 |  | 1 | 1 | 1 | Anaheim Automation Part No. 42Y312D-LW8 | No |  |  |  |  | 7 | 7 | $808.31 | $808.31
2 | 3 | 1 | 2 |  | Gear Box | 1 |  | 1 | 1 | 1 |  | No |  |  |  |  |  |  | $334.00 | $334.00
2 | 3 | 1 | 3 |  | Timing Belt | 1 |  | 1 | 1 | 1
2 | 3 | 1 | 4 |  | Timing Belt Pulley Small | 1 | Aluminum | 1 | 1 | 1 | McMaster Part No. 1304N11 | No |  |  |  |  |  |  | $22.89 | $22.89
2 | 3 | 1 | 5 |  | Timing Belt Pulley Large | 2 | Aluminum | 1 | 1 | 1 | McMaster Part No. 1304N2 | No |  |  |  |  |  |  | $88.18 | $176.36
2 | 3 | 1 | 6 |  | Pillow Block | 3 | PC | 1 | 1 | 1 |  | No | 3D Print |  |  |  |  |  |  | $0.00
2 | 3 | 1 | 7 |  | Small Shaft Bearing | 3 |  | 1 | 1 | 1 | McMaster No. 60355K505 | No |  |  |  |  |  |  | $6.27 | $18.81
2 | 2 | 0 | 0 |  | Electrical Shielding
2 | 2 | 1 | 0 |  | Copper Bore | 1 | Copper | 1 | 1 | 1 |  | No |  |  |  |  | 9.06 | 9.06 | $295.72 | $295.72
2 | 2 | 2 | 0 |  | Main Copper Box | 1 | Copper | 1 | 1 | 1
2 | 2 | 2 | 1 |  | Copper Box Side | 4 | Copper | 1 | 1 | 1 |  | No |  |  |  |  | 3.55 | 14.2 | $176.24 | $704.96
2 | 2 | 2 | 1 | A | Copper Box Side_Hole | 1 | Copper | 1 | 1 | 1 |  | No |  |  |  |  | 3.55 | 3.55 | $176.24 | $176.24
2 | 2 | 2 | 1 | B | Copper Box Side_Feedthrough | 1 | Copper | 1 | 1 | 1 |  | No |  |  |  |  | 3.55 | 3.55 | $176.24 | $176.24
2 | 2 | 2 | 1 | C | BNC Feedthrough | 5 |  | 1 | 1 | 1
2 | 2 | 2 | 2 |  | Brass Angle Bracket | 8 | Brass | 1 | 1 | 1 |  | No |  |  |  |  |  |  | $16.98 | $135.80
2 | 2 | 3 | 0 |  | Tx Filter Box | 1 | Aluminum | 1 | 1 | 1 | McMaster No. 75775K160 | No |  |  |  |  | 3.1 | 3.1 | $476.22 | $476.22
2 | 2 | 4 | 0 |  | Motor Shield Box | 1 | Steel | 1 | 1 | 1 | McMaster No. 75065K420 | No |  |  |  |  | 6 | 6 | $74.84 | $74.84
2 | 2 | 5 | 0 |  | Bed Stepper Driver Box | 1 | Die Cast Aluminum | 1 | 1 | 1 | McMaster No. 75895k37 or similar | No |  |  |  |  |  |  | $24.93 | $24.93
2 | 2 | 5 | 1 |  | Stepper Driver Board
3 | 0 | 0 | 0 |  | Inside Bore and Rails |  |  | 1 | 1 | 1
3 | 1 | 0 | 0 |  | Tx Rx Coils |  |  | 1 | 1 | 1
3 | 2 | 0 | 0 |  | Rail and Bed Assembly |  |  | 1 | 1 | 1
3 | 2 | 1 | 0 |  | Bed Rails | 1 |  | 1 | 1 | 1
3 | 2 | 1 | 1 |  | Bed Rail Clamp | 1 |  | 1 | 1 | 1
3 | 2 | 1 | 2 |  | Bed Rail Base Junction | 1 |  | 1 | 1 | 1
3 | 2 | 1 | 3 |  | Bed Holder | 1 |  | 1 | 1 | 1
3 | 2 | 1 | 4 |  | Bed Rail End | 1 |  | 1 | 1 | 1
3 | 2 | 1 | 5 | a | Rail Conenctor Rod | 10 | Fiberglass | 1 | 1 | 1 | McMaster No. 8543k49 or similar | No |  |  |  |  |  |  | $0.50 | $5.00
3 | 2 | 1 | 5 | b | Rail Connector Rod | 5 | Fiberglass | 1 | 1 | 1 | McMaster No. 8543k49 or similar | No |  |  |  |  |  |  | $1.00 | $5.00
3 | 2 | 1 | 6 |  | Rail Brass Track | 2 | Brass | 1 | 1 | 1 | McMaster No.8954K23 | No |  |  |  |  |  |  | $9.98 | $19.96
3 | 2 | 1 | 7 |  | Stepper Motor | 1 |  | 1 | 1 | 1 | Sparkfun No. 10846, 68oz.in 400 steps/rev | No |  |  |  |  |  |  | $17.95 | $17.95
3 | 2 | 1 | 7 | a | Stepper Motor Plate | 1 | Aluminum | 1 | 1 | 1
3 | 2 | 1 | 7 | b | M2 Timing Belt Pulley | 1 | Aluminum | 1 | 1 | 1 | Adafruit No. 1251 or similar GT2 pulley | No |  |  |  |  |  |  | $7.95 | $7.95
3 | 2 | 1 | 8 |  | Coil Holder End | 1 | PC | 1 | 1 | 1
3 | 2 | 1 | 9 |  | Center Rung | 2 | PC | 1 | 1 | 1
3 | 2 | 1 | 10 |  | Lock Wedge | 1 | PC | 1 | 1 | 1
3 | 2 | 1 | 11 |  | Lock Wedge Backing |  | PC | 1 | 1 | 1
3 | 2 | 1 | 12 |  | Timing Belt | 1 |  | 1 | 1 | 1 | Digikey No. 1528-2087-ND | No |  |  |  |  |  |  | $9.95 | $9.95
3 | 2 | 2 | 0 |  | Bed and Phantom Holders |  |  | 1 | 1 | 1
3 | 2 | 2 | 1 |  | Rat Bed Base | 1 |  | 1 | 1 | 1
3 | 2 | 3 | 0 |  | Positioning Equipment
3 | 2 | 3 | 1 |  | Camera | 1 |  | 1 | 1 | 1 | Newegg No. 9SIAD6H5EF8273 | No |  |  |  |  |  |  | $92.99
3 | 2 | 3 | 2 |  | Laser | 1 |  | 1 | 1 | 1 | Digikey No. 1528-1403-ND or similar | No |  |  |  |  |  |  | $8.95
3 | 2 | 3 | 1 | a | Camera Bracket | 1 |  | 1 | 1 | 1
3 | 2 | 3 | 2 | a | Laser Bracket | 1 |  | 1 | 1 | 1
3 | 2 | 4 | 0 |  | Wire Cart
3 | 2 | 4 | 1 |  | Cart Base | 1
3 | 2 | 4 | 2 |  | Bass Shafts | 4
4 | 0 | 0 | 0 |  | Computers and Amplifiers |  |  | 1 | 1 | 1
4 | 1 | 0 | 0 |  | Power Amplifiers |  |  | 1 | 1 | 1
4 | 1 | 1 | 0 |  | Shift Amplifier | 1 |  |  |  |  | Price Approximated, you can also use AE Techron 7548 for this, but may be FOV limited with high duty cycles | No |  |  |  |  |  |  | $30000.00 | $30000.00
4 | 1 | 2 | 0 |  | Drive Amplifier | 1 |  |  |  |  | AE Techron 7548 Price Approximated | No |  |  |  |  |  |  | $10000.00 | $10000.00
4 | 2 | 0 | 0 |  | Computers and DAQs
4 | 2 | 1 | 0 |  | Computers
4 | 2 | 1 | 1 |  | Main CPU | 1 |  |  |  |  | Dell Precision 7730 | No |  |  |  |  |  |  | $3175.55 | $3175.55
4 | 2 | 1 | 2 |  | CPU Rack | 1 |  |  |  |  | Dell Precision 3930 Rack | No |  |  |  |  |  |  | $2715.64 | $2715.64
4 | 2 | 2 | 0 |  | Data Acquisition |  |  |  |  |  |  |  |  |  |  |  |  |  | $10000.00 | $10000.00
