OS-MPI/Small-Bore-Imager/General Documentation/Modeling/Magnetics/Magnet_Cross_Section_ExplicitLayers_Plus16AWG.dxf

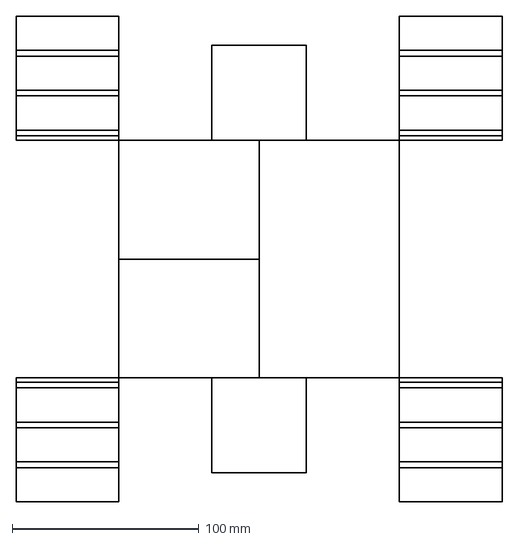
[picture p32: CAD file, 2019-11-12]
General Documentation/Modeling/Magnetics/Magnet_Cross_Section_ExplicitLayers_Plus16AWG.dxf
260.0 x 259.8 mm
