OS-MPI/Small-Bore-Imager/General Documentation/Modeling/Thermal/Cross_Section_4x20_1.5mmSiC_ExtraLayer.dxf

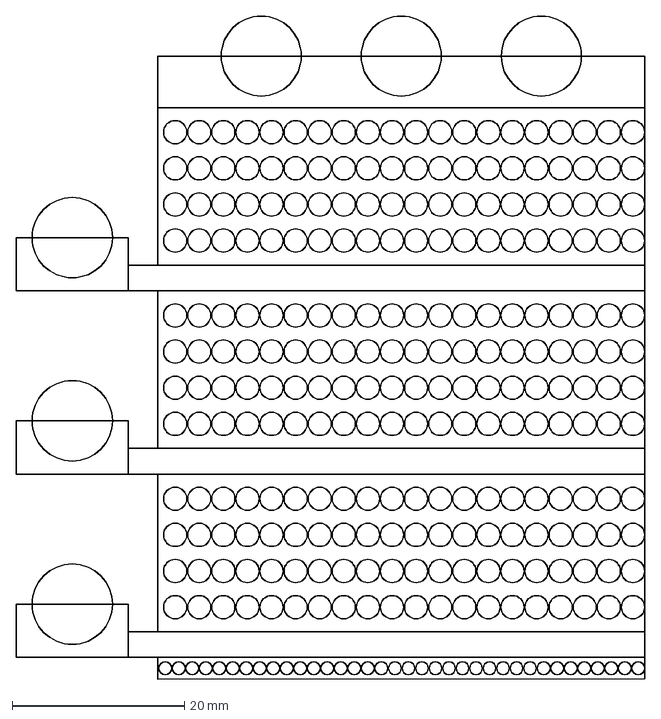
[picture p33: CAD file, 2019-11-12]
General Documentation/Modeling/Thermal/Cross_Section_4x20_1.5mmSiC_ExtraLayer.dxf
73.0 x 77.1 mm
