OS-MPI/Small-Bore-Imager/General Documentation/Modeling/Magnetics/Magnet_Cross_Section.dxf

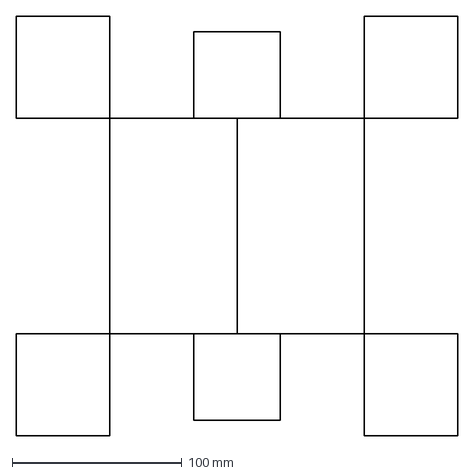
[picture p34: CAD file, 2019-11-12]
General Documentation/Modeling/Magnetics/Magnet_Cross_Section.dxf
260.0 x 247.0 mm
