OS-MPI/Small-Bore-Imager/General Documentation/Modeling/Thermal/Cross_Section_4x20_1.5mmSiC.dxf

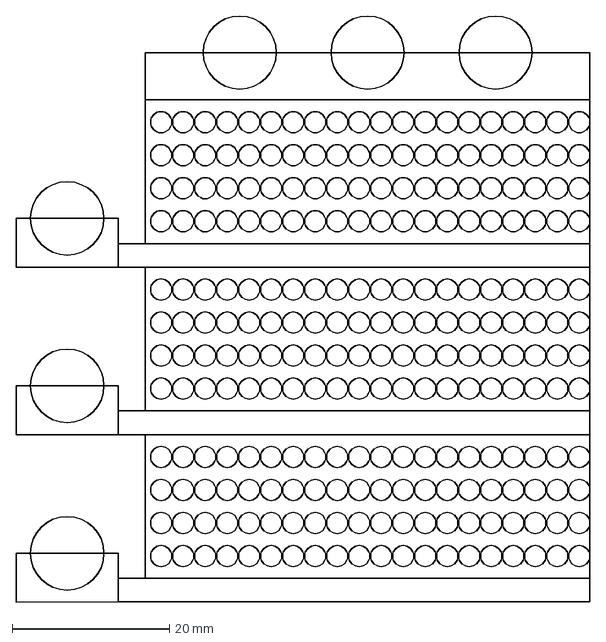
[picture p35: CAD file, 2019-11-12]
General Documentation/Modeling/Thermal/Cross_Section_4x20_1.5mmSiC.dxf
73.0 x 74.6 mm
