OS-MPI/Small-Bore-Imager/(list of files, cad)

Other CAD files:
General Documentation/Modeling/Magnetics/Magnet_Cross_Section.ipt
General Documentation/Modeling/Magnetics/OldVersions/Magnet_Cross_Section.0001.ipt
General Documentation/Modeling/Thermal/Cross_Section_4x20_1.5mmSiC.ipt
General Documentation/Modeling/Thermal/Cross_Section_4x20_1.5mmSiC_Extra14AWGLayer.ipt
General Documentation/Modeling/Thermal/OldVersions/Cross_Section_4x20_1.5mmSiC.0001.ipt
Inventor Files/1xxx_Rotating Gantry/11xx_Magnet Assembly/111x_Permanent Magnets/1111A_Individual NdFeB Block_V1.ipt
Inventor Files/1xxx_Rotating Gantry/11xx_Magnet Assembly/111x_Permanent Magnets/1111_Magnet Brick SubAssembly_V1.iam
Inventor Files/1xxx_Rotating Gantry/11xx_Magnet Assembly/111x_Permanent Magnets/1112_Magnet Brick Housing_V1.ipt
Inventor Files/1xxx_Rotating Gantry/11xx_Magnet Assembly/1120_Shift Coil Assembly_V1.iam
Inventor Files/1xxx_Rotating Gantry/11xx_Magnet Assembly/112x_Shift Coil Assembly/1121A_Shift Coil Layer_V1.ipt
Inventor Files/1xxx_Rotating Gantry/11xx_Magnet Assembly/112x_Shift Coil Assembly/1121_Shift Coils SubAssembly_V1.iam
Inventor Files/1xxx_Rotating Gantry/11xx_Magnet Assembly/112x_Shift Coil Assembly/1122A_Middle Heat Sink Mirror_V1.ipt
Inventor Files/1xxx_Rotating Gantry/11xx_Magnet Assembly/112x_Shift Coil Assembly/1122_Middle Heat Sink_V1.ipt
Inventor Files/1xxx_Rotating Gantry/11xx_Magnet Assembly/112x_Shift Coil Assembly/1123B_Top Heat Sink Mirror_V1.ipt
Inventor Files/1xxx_Rotating Gantry/11xx_Magnet Assembly/112x_Shift Coil Assembly/1123_Top Heat Sink_V1.ipt
Inventor Files/1xxx_Rotating Gantry/11xx_Magnet Assembly/1130_Watery Rotary Union Assembly_V1.iam
Inventor Files/1xxx_Rotating Gantry/11xx_Magnet Assembly/113x_Water Rotary Union Assembly/11310_Pipe Inserts_V1.ipt
Inventor Files/1xxx_Rotating Gantry/11xx_Magnet Assembly/113x_Water Rotary Union Assembly/1131_Inner RU Body_V1.ipt
Inventor Files/1xxx_Rotating Gantry/11xx_Magnet Assembly/113x_Water Rotary Union Assembly/1132_Outer RU Body_V1.ipt
Inventor Files/1xxx_Rotating Gantry/11xx_Magnet Assembly/113x_Water Rotary Union Assembly/1133_RU End Cap.ipt
Inventor Files/1xxx_Rotating Gantry/11xx_Magnet Assembly/113x_Water Rotary Union Assembly/1134_RU O Ring Cap_V1.ipt
Inventor Files/1xxx_Rotating Gantry/11xx_Magnet Assembly/113x_Water Rotary Union Assembly/1135_Sq O Ring_V1.ipt
Inventor Files/1xxx_Rotating Gantry/11xx_Magnet Assembly/113x_Water Rotary Union Assembly/1136_RU Top Plate_V1.ipt
Inventor Files/1xxx_Rotating Gantry/11xx_Magnet Assembly/113x_Water Rotary Union Assembly/1137_RU Mechanical Connector_V1.ipt
Inventor Files/1xxx_Rotating Gantry/11xx_Magnet Assembly/113x_Water Rotary Union Assembly/1138_Inner Gasket_V1.ipt
Inventor Files/1xxx_Rotating Gantry/11xx_Magnet Assembly/113x_Water Rotary Union Assembly/1139_Outer Gasket_V1.ipt
Inventor Files/1xxx_Rotating Gantry/12xx_Gantry Structure/121x_Gantry Structure Assembly/1211_Racetrack Board_V1.ipt
Inventor Files/1xxx_Rotating Gantry/12xx_Gantry Structure/121x_Gantry Structure Assembly/1212_Flat Connector_V1.ipt
Inventor Files/1xxx_Rotating Gantry/12xx_Gantry Structure/121x_Gantry Structure Assembly/1213_Angle Stock Bracket_V1.ipt
Inventor Files/1xxx_Rotating Gantry/12xx_Gantry Structure/121x_Gantry Structure Assembly/1214_Gantry Support Rib_V1.ipt
Inventor Files/1xxx_Rotating Gantry/12xx_Gantry Structure/121x_Gantry Structure Assembly/1215_Bearing_V1.ipt
Inventor Files/1xxx_Rotating Gantry/12xx_Gantry Structure/121x_Gantry Structure Assembly/1216_Bearing Clamps NoPulley_V2.ipt
Inventor Files/1xxx_Rotating Gantry/12xx_Gantry Structure/121x_Gantry Structure Assembly/1217A_Bearing Clamps Gear_V1.ipt
Inventor Files/1xxx_Rotating Gantry/12xx_Gantry Structure/121x_Gantry Structure Assembly/1217B_Bearing Clamps Gear_V1.ipt
Inventor Files/1xxx_Rotating Gantry/12xx_Gantry Structure/121x_Gantry Structure Assembly/1217C_Bearing Clamps Gear_V1.ipt
Inventor Files/1xxx_Rotating Gantry/12xx_Gantry Structure/121x_Gantry Structure Assembly/1217D_Bearing Clamps Gear_V1.ipt
Inventor Files/2100_45mm Framing-01-02.ipt
Inventor Files/2100_45mm Framing-01-021.ipt
Inventor Files/2100_45mm Framing-01-022.ipt
Inventor Files/2100_45mm Framing-01-023.ipt
Inventor Files/2xxx_Stationary Structure/21xx_Imager Frame/2100_Framing Components/2100_45mm Framing.ipt
Inventor Files/2xxx_Stationary Structure/21xx_Imager Frame/2100_Framing Components/ALUMINUM T-SLOTTED FRAMING EXTRUSION-011.ipt
Inventor Files/2xxx_Stationary Structure/21xx_Imager Frame/2100_Framing Components/ALUMINUM T-SLOTTED FRAMING EXTRUSION-013.ipt
Inventor Files/2xxx_Stationary Structure/21xx_Imager Frame/2100_Framing Components/ALUMINUM T-SLOTTED FRAMING EXTRUSION-014.ipt
Inventor Files/2xxx_Stationary Structure/21xx_Imager Frame/2100_Framing Components/ALUMINUM T-SLOTTED FRAMING EXTRUSION-015.ipt
Inventor Files/2xxx_Stationary Structure/21xx_Imager Frame/2100_Framing Components/ALUMINUM T-SLOTTED FRAMING EXTRUSION.ipt
Inventor Files/2xxx_Stationary Structure/21xx_Imager Frame/212x_Other Supports/2121_Copper Tube Clamp Bottom_V1.ipt
Inventor Files/2xxx_Stationary Structure/21xx_Imager Frame/212x_Other Supports/2122_Copper Tube Clamp Top_V1.ipt
Inventor Files/2xxx_Stationary Structure/21xx_Imager Frame/212x_Other Supports/2123_Alum Angle Bracket_V1.ipt
Inventor Files/2xxx_Stationary Structure/21xx_Imager Frame/212x_Other Supports/2124_Plywood Frame Top_V1.ipt
Inventor Files/2xxx_Stationary Structure/21xx_Imager Frame/212x_Other Supports/2125_Wood Bench Top_V1.ipt
Inventor Files/2xxx_Stationary Structure/21xx_Imager Frame/212x_Other Supports/2126_Al Frame End Cap_V1.ipt
Inventor Files/2xxx_Stationary Structure/22xx_Electrical Shielding/2210_Copper Bore_V1.ipt
Inventor Files/2xxx_Stationary Structure/22xx_Electrical Shielding/2220_Main Copper Box_V1.iam
Inventor Files/2xxx_Stationary Structure/22xx_Electrical Shielding/222x_Main Copper Box/2221A_Copper Box Side_Hole_V1.ipt
Inventor Files/2xxx_Stationary Structure/22xx_Electrical Shielding/222x_Main Copper Box/2221B_Copper Box Side_Feedthrough_V1.ipt
Inventor Files/2xxx_Stationary Structure/22xx_Electrical Shielding/222x_Main Copper Box/2221C_BNC Feedthrough_V1.ipt
Inventor Files/2xxx_Stationary Structure/22xx_Electrical Shielding/222x_Main Copper Box/2221_Copper Box Side_V1.ipt
Inventor Files/2xxx_Stationary Structure/22xx_Electrical Shielding/222x_Main Copper Box/2222_Brass Angle Bracket_V1.ipt
Inventor Files/2xxx_Stationary Structure/22xx_Electrical Shielding/2230_Tx Filter Box Assembly_V1.iam
Inventor Files/2xxx_Stationary Structure/22xx_Electrical Shielding/2231_Tx Filter Box_V1.ipt
Inventor Files/2xxx_Stationary Structure/22xx_Electrical Shielding/223x_Tx Filter Box/2231_Tx Filter Box_V1.ipt
Inventor Files/2xxx_Stationary Structure/22xx_Electrical Shielding/2240_Motor Shield Box_V1.ipt
Inventor Files/2xxx_Stationary Structure/23xx_Driving Mechanics/231x_Drive Train/2311_Motor_V1.ipt
Inventor Files/2xxx_Stationary Structure/23xx_Driving Mechanics/231x_Drive Train/2312_Gear Box_V1.ipt
Inventor Files/2xxx_Stationary Structure/23xx_Driving Mechanics/231x_Drive Train/2313_Timing Belt_V1.ipt
Inventor Files/2xxx_Stationary Structure/23xx_Driving Mechanics/231x_Drive Train/2314_Timing Belt Pulley Small_V1.ipt
Inventor Files/2xxx_Stationary Structure/23xx_Driving Mechanics/231x_Drive Train/2315_Shaft_V1.ipt
Inventor Files/2xxx_Stationary Structure/23xx_Driving Mechanics/231x_Drive Train/2316_Pillow Block_V1.ipt
Inventor Files/2xxx_Stationary Structure/23xx_Driving Mechanics/231x_Drive Train/2317_Small Shaft Bearing_V1.ipt
Inventor Files/2xxx_Stationary Structure/24xx_Misc Including Water Cooling/241x_Water Cooling/2411_Water Bucket_V1.ipt
Inventor Files/3xxx_Inside Bore and Rails/3000_Inside Bore and Rails_V1.iam
Inventor Files/3xxx_Inside Bore and Rails/3100_TxRx Assembly_V1.iam
Inventor Files/3xxx_Inside Bore and Rails/31xx_TxRx Coils/3111_Tx Inner Layer_V1.ipt
Inventor Files/3xxx_Inside Bore and Rails/31xx_TxRx Coils/3112_Tx Outer Layer_V1.ipt
Inventor Files/3xxx_Inside Bore and Rails/31xx_TxRx Coils/3113_Rx Coil_V1.ipt
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
