OS-MPI/Small-Bore-Imager/Images/1130_Watery Rotary Union Assembly_V1.png

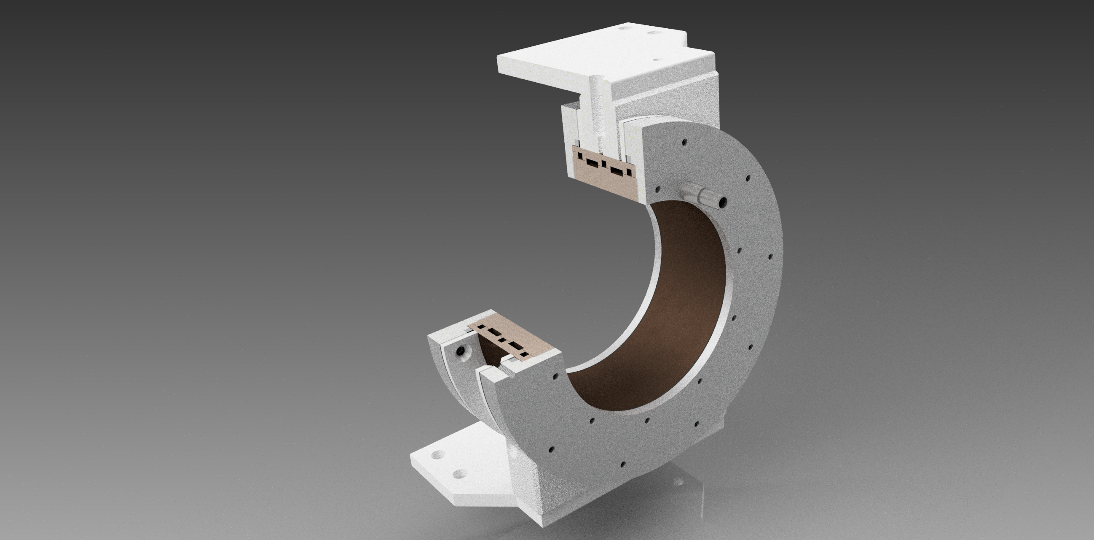
Images/1130_Watery Rotary Union Assembly_V1.png
