OS-MPI/Small-Bore-Imager/Images/3100_TxRx Assembly_V1cutaway.jpg

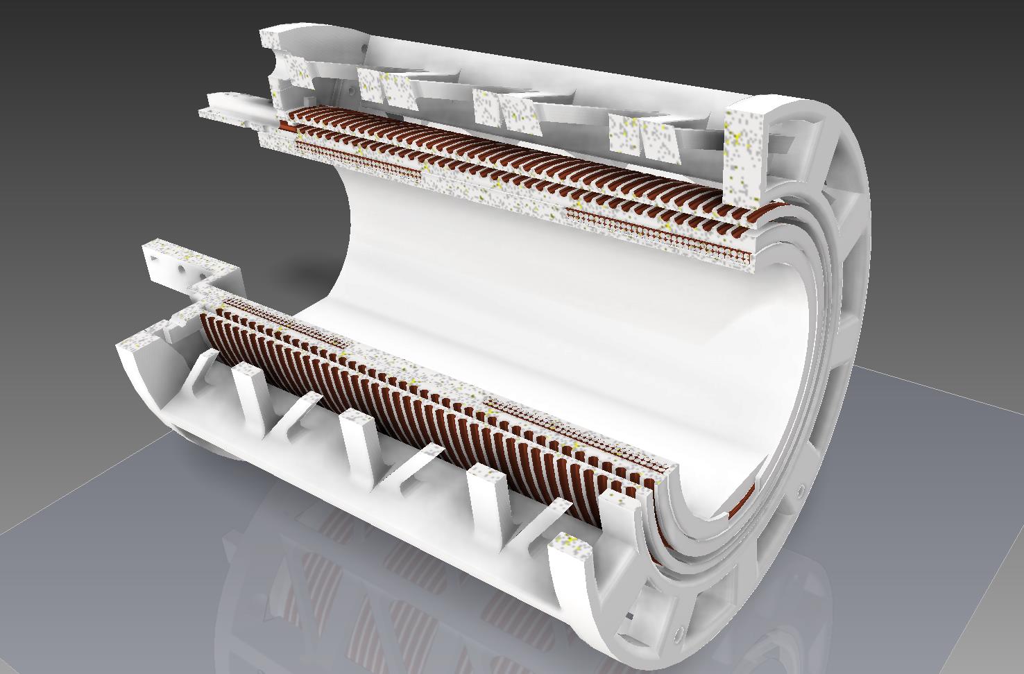
Images/3100_TxRx Assembly_V1cutaway.jpg
