OS-MPI/Small-Bore-Imager/Filters/tx_filter_Meas_values-OS-MPI.asc

C1: cap; 329.8n tc={TCCap}; Rser=10m
C2: cap; 3.2µ; Rser=10m
C2a: cap; 379n tc={TCCap}; Rser=10m
C3: cap; 242.8n tc={TCCap}; Rser=10m
C4: cap; 95n tc={TCCap}
C6: cap; 188n tc={TCCap}; Rser=10m
L1: ind2; 1
L2: ind; 215.5µ; Rser=.3179
L3: ind; 107.2µ; Rser=200m
L4: ind; 129µ
L5: ind; 2µ
L6: ind2; 1
L7: ind; 122µ
L8: ind; 1m
R1: res; 300m
R2: res; 100
V1: voltage; SINE(0 1 25e3); AC 1; Rser=0
Named nets: Vamp, 0, Vsrc
.param TCCap=-.0003 TCCap1=0
;.param TCCap=-.000
;.ac list 25e3
.ac oct 1k 1k 100k
;.tran 0 10m 0 9m
(I(L4)^2*.42)/(I(V1)*V(Vsrc))
K L1 L6 1
