OS-MPI/Small-Bore-Imager/(commit log)

2019-11-12 Initial File Dump
    [1111A_Individual NdFeB Block_V1.ipt, 1111_Magnet Brick SubAssembly_V1.iam, 1112_Magnet Brick Housing_V1.ipt, 1120_Shift Coil Assembly_V1.iam, 1121A_Shift Coil Layer_V1.ipt, 1121_Shift Coils SubAssembly_V1.iam, 1122A_Middle Heat Sink Mirror_V1.ipt, 1122_Middle Heat Sink_V1.ipt]
2020-09-08 Update OSMPI Part Management-MPI.xlsx
    [OSMPI Part Management-MPI.xlsx]
2021-11-03 Add updated filter
2021-11-03 Initial Tx filter design doc
